SNI22/crucible_lite/docs/device_context.md

# Device Context — RAG Evidence Base

This file is the primary evidence document for all agents operating under the
Crucible Constitutional Governance system. It is read by attorneys before
constructing hearing arguments, by the hw-advisor before making suggestions,
and by the simulator-operator when validating simulation parameters against
known hardware behaviour.

**Agents: read this file before any hearing argument or advisory session.**  
**Humans: keep this file current. A stale BOM or outdated test result here is
a constitutional violation under Article I (Signal First).**

Maintained by: human engineer (primary) + `/toolchain` command (hardware/pin sections).  
Updated after: every field test session, every BOM revision, every schematic change.

---

## Device Purpose

This device detects falls of an elderly person in a bathroom by sensing floor
vibration, then prompts the user to confirm whether help is needed. If no
"no" response is received within a fixed timeout, the device escalates to an
external channel (caregiver / family / emergency services — escalation
transport is out of scope for this project). The dependency chain is:
floor-vibration event → on-device fall classification → user prompt →
verbal/manual acknowledgment or escalation. A false positive prompts the
elderly user unnecessarily (recoverable annoyance, budgeted at ≤ 1 per
7 days). A false negative leaves an injured or unconscious person on the
bathroom floor with no alarm — the catastrophic failure the device exists
to prevent.

**Project target:** Detect a fall of an elderly person on a bathroom-tile
floor at up to 3 m range, including the slow-controlled-descent (slump)
case, while rejecting heavy footsteps, dropped objects, and bathroom
plumbing vibration (shower / flush / drain).

**Pass/fail threshold:**
- Sensitivity ≥ 95 % of real falls detected within 30 s of fall onset,
  covering fast falls, slow slumps, and falls at the 3 m far-range case.
- False positive rate ≤ 1 alarm per 7 days of typical bathroom use.
- Detection latency: alarm prompt fires within 30 s of fall onset.

**Domain primitives** (traces to Article I — ratified by Amendment 1):
1. **Floor acceleration** (m/s²) — inertial response of the bathroom floor
   to mechanical events on it.
   Measured via: piezo (PVDF + proof-mass cantilever) at ≥ 1 kHz.
   FIRMWARE NOTE (2026-05-16): active firmware streaming rate is
   INT_MARK-dependent (0=~1.9 kHz default, 1=500 Hz, 2=200 Hz, etc.).
   The ≥ 1 kHz clause requires INT_MARK=0 in deployment.
2. **Acoustic pressure** (Pa, or normalized) — sound pressure in the
   bathroom air, both broadband (environment classification) and
   speech-band (verbal-response detection).
   Measured via: microphone (digital I2S MEMS recommended; pinned at
   `/toolchain init`).
3. **Human room occupancy** (boolean, with optional confidence) — whether
   a human body is present in the monitored room.
   Measured via: WiFi sensing module (output interface pinned at
   `/toolchain init`).

**Operating envelope:**
- **Normal:** ceramic / porcelain tile floor, PVDF+mass cantilever
  epoxied across full base footprint, ≤ 3 m max fall range, 15–30 °C,
  30–95 %RH, mains-powered, always-on 24/7.
- **Worst-case (still in-scope):** active shower running, toilet flush +
  tap running, neighbor footsteps through shared wall/floor, door slammed,
  brief second-person presence (helper / delivery), bath mat partially
  covering the floor, splash on enclosure (splash-rated, not submerged).
- **Out-of-scope:** outdoor / submerged deployment; multi-person
  bathrooms; floors over springy subfloor (joist over basement);
  carpet / soft flooring; rugs covering the device; detection of falls
  outside the monitored room; whole-house single-device monitoring.

---

## Install-Time Calibration Design (planned, Stage 2/3 deliverable)

To generalize across the wide variation in real bathrooms (tile size,
bonding, subfloor, wall coupling, ambient noise, sensor placement),
the device performs a one-time install calibration. This is the
generalization strategy of record per 2026-05-16 — the simulator does
NOT need to model every bathroom variation accurately; the install
calibration captures the actual deployment's response.

**Three-step install calibration:**

| Step | Duration | What is measured | How algorithm uses it |
|---|---|---|---|
| 1. Quiet baseline | 60 s | Ambient noise floor RMS + spectrum (vent, plumbing, washer if present) | Set adaptive event-detection thresholds; baseline-RMS becomes the denominator for SNR-based features |
| 2. Impulse test at 3 distances (calibrated jig-driven) | ~2 min | Impulse response at known xy positions (e.g., 0.5 m, 1.5 m, 2.5 m from sensor) | Measures actual plate damping, spatial decay rate, local tile resonance, and bonding state — ALL bathroom-specific physics in one measurement. Jig required (NOT fingernail) because result is fit quantitatively. |
| 3. Calibration walk | ~1 min | Real footstep signature at moderate pace | Confirms walking-discriminator features work in this bathroom; sets reference amplitude for "normal walking" used by adaptive thresholds |

**What this absorbs:**
- Multi-tile mosaic effects (lateral grout damping)
- Tile size + bonding state (local response in step 2)
- Subfloor variation (slab vs joist appears as different impulse response shape)
- Wall coupling (affects boundary modes captured in step 2)
- Vent / washer locations (captured in step 1 baseline)
- Sensor placement xy (implicit — the IR is from the sensor's actual location)

**What the algorithm requires to leverage calibration:**
- Adaptive event thresholds (MAD-based, already in `src/algorithm.py`)
- Scale-invariant features for classification (band fractions, ratios — partially in features; could be extended)
- Calibration-derivable amplitude reference (e.g., "fall energy ≥ K × measured-walking-energy" instead of "≥ X mg")
- Decay-time reference relative to plate signature ("post-event RMS returns to baseline in ≤ N × plate-ringdown-tau" instead of "≤ M ms")

The first two are in scope for the algorithm as it stands. The third
and fourth would be a feature-engineering pass at Stage 2/3, after
real calibration-measurement data is available.

**Simulator implications:**

This calibration strategy makes most per-bathroom simulator detail
unnecessary:
- Multi-tile mosaic modeling — defer (calibration captures lateral
  grout damping)
- Exact plate-damping value — defer (calibration measures the actual
  damping in impulse test)
- Exact bathroom geometry — defer (calibration captures spatial decay)
- Furniture mass loading — defer (captured in baseline)

The simulator IS still needed for:
- Algorithm development (representative-enough signals to validate logic)
- Structural physics that's bathroom-independent (multi-impact rebound,
  body-fall multi-stage signature, slow-slump dynamics, sensor model)

This re-prioritizes the simulator-improvement roadmap toward STRUCTURAL
features and away from per-bathroom parameter accuracy.

---

## Signal Inventory

| Signal | Physical quantity | Unit | Normal range | Hard limits | Sample rate | Primitive |
|---|---|---|---|---|---|---|
| Piezo (PVDF+mass) | Floor acceleration | m/s² (derived from V via charge-amp transfer function) | ±0.5 g typical bathroom activity | clip at front-end rail (≈ ±5 V at ADC input) | Active firmware: INT_MARK-dependent (default 0 → ~1.9 kHz; INT_MARK=1 → 500 Hz). Must be INT_MARK=0 to satisfy P1's ≥ 1 kHz clause | P1 |
| Microphone — broadband channel | Acoustic pressure | Pa (or 16-bit PCM count) | 30–80 dB SPL room ambient | clip at digital full-scale | 8–16 kHz (TBD at /toolchain init) | P2 |
| Microphone — speech-band channel | Acoustic pressure (300–3400 Hz) | Pa (or 16-bit PCM count) | response-time speech bursts | clip at digital full-scale | derived from broadband channel | P2 |
| WiFi sensing | Human room occupancy | boolean (+ optional confidence 0–1) | 0 or 1 with confidence ≥ 0.7 stable | sensor-not-responding watchdog | event-driven or 1 Hz poll (TBD) | P3 |

**Stretch / cost-gated sensors (deferred to /toolchain init decision):**
- PIR — only if WiFi-sensing presence proves unreliable in bathroom RF environment
- IMU on device housing — only if device housing itself gets bumped causing piezo false positives
- MLX thermal — likely too expensive; skip

**Pre-existing assets carried in from `~/Documents/piezo_circuit/`:**
- Charge-amplifier front-end (CA3140 or MAX44248, 100 MΩ ∥ 10 nF feedback)
- Sensor-mounting protocol (`SENSOR_MOUNTING.md` — PVDF+mass cantilever, full-area epoxy) — superseded by the housing design below for piezo_fall
- Walk-vs-fall characterization protocol (`WALK_VS_FALL_PROTOCOL.md`)
- Feature dictionary (peak, energy, duration, spectral centroid, band ratios, decay shape, multi-peak count, footstep cadence) — pending augmentation with a slump-rumble feature

**Deployment-specific sensor housing (piezo_fall):**

CAD file: `~/Documents/piezo_circuit/ground_cantilever_housing.{stp,stl}`
(user-designed, 2026-05-16, confirmed correct via review).

Architecture: 3 rigid sections stacked along Z, single rigid load path
from preload weight → top platform → PCB clamp → baseplate → floor.

| Section | Z range (mm) | Function |
|---|---|---|
| Baseplate | -8 to -5 | Square 35×35 mm, ~3 mm thick — flat ground contact. Single-tile sized (well under standard 200 mm bathroom tile, no grout-joint bridging). |
| PCB clamp / bracket | -5 to +10 | Through-slot grips MiniSense PCB edges. Pins/connectors route out top and bottom of the slot. Cantilever projects into the housing interior cavity with free air on all sides — no contact with walls or cap. |
| Top platform / cap | +10 to +14.5 | Cylindrical disc ~30 mm diameter, flat top — surface for the 200 g preload weight to sit on. |

**Preload:** ~200 g loose weight resting on top platform. Not bonded —
removable for transport, repeatable on re-install. Range 100–500 g all
acceptable; the figure isn't precision-critical.

**Why this preserves the datasheet sensor model:**

- Cantilever has free air around the tip mass → 2nd-order dynamics
  (fn ≈ 75 Hz, ζ ≈ 0.092) preserved. No clamping → no resonance shift.
- Rigid hard-on-hard load path (PLA/PETG print → MiniSense PCB →
  baseplate → tile) → base-on-floor follow-the-floor resonance well
  above 1 kHz. Faithful floor tracking in the 0–200 Hz band of interest.
- 35 mm baseplate within one tile → no inter-tile rocking modes.

**What still needs install-time impulse-test verification:**

Even with a correct housing design, the *as-deployed* coupling depends
on tile flatness, dust, the specific tile, and operator placement.
The 30-second impulse test in step 2 of the install calibration above
serves double duty: records IR data for fitting AND validates coupling
qualitatively (fingernail tap 30 cm from sensor → expect clean impulse
with ringdown < 50 ms). Long ringing or delayed rise = compliant contact,
fix the deploy before any further recording.
- ESP32-S3 host-streaming firmware (5 kHz reference; will be adapted to project firmware)
- Bedroom + livingroom test data; **bathroom fall data does not yet exist** and is a Stage 1 data-collection requirement

---

## Simulation Profile Catalog

> Locked at Stage 1 entry (2026-05-15). Each profile is a composite of one
> always-on background source (ventilator) plus optional plumbing/noise
> sources plus an optional event. Used by `src/signals.py::generate(profile, ...)`
> to produce labeled sensor traces for the detector under test.
> Background sources: `vent_humming` is always injected (always-on bathroom
> exhaust fan, ~50–60 Hz motor + harmonics). Other sources documented per profile.

### Class breakdown

| Class | Algorithm output | Purpose |
|---|---|---|
| **noise** | not-fall | Continuous/ambient sources, no discrete event. Tests baseline sensitivity. |
| **confuser** | not-fall | Discrete events that look fall-like but aren't. Tests discrimination logic. |
| **fall** | fall | The positive case. Tests sensitivity. |

### Profiles

| # | Profile | Class | Composition |
|---|---|---|---|
| 1 | `noise_vent` | noise | vent only |
| 2 | `noise_shower` | noise | vent + shower (continuous water-on-tile, ~3 min) |
| 3 | `noise_flush` | noise | vent + toilet-flush transient (~30 s) |
| 4 | `noise_washer_local` | noise | vent + washing machine on spin in same unit (direct floor coupling) |
| 5 | `noise_washer_neighbor` | noise | vent + neighbor's washer (through-wall + shared-floor attenuation) |
| 6 | `confuser_step` | confuser | vent + far step at 3 m (Case 2: far step ≈ close fall amplitude) |
| 7 | `confuser_drop_phone` | confuser | vent + light rigid drop (~150–200 g "phone-class" object). NOTE: name is legacy; real-world data collection MUST use a surrogate (power-adapter brick, hardback book, etc.) NOT an actual phone. See `docs/data_collection_protocol.md` Phase B2. |
| 8 | `confuser_drop_heavy` | confuser | vent + heavy rigid drop (~600 g hair dryer / electric razor) |
| 9 | `confuser_drop_glass` | confuser | vent + brittle multi-impact drop. NOTE: name is legacy; real-world data collection MUST use a SAFE multi-impact surrogate (small bag of dried pasta or marbles in a thin bag) — DO NOT break glassware in the bathroom. See `docs/data_collection_protocol.md` Phase B3. |
| 10 | `fall_fast` | fall | vent + fast fall at 3 m (200 J effective floor impact) |
| 11 | `fall_slump` | fall | vent + shower + slow slump at 3 m (worst case: slump + plumbing FP + far range) |

### Evaluation metrics

| Metric | Source | Target |
|---|---|---|
| Sensitivity | fraction of class `fall` correctly classified as fall | ≥ 95 % |
| FP rate on noise | fraction of class `noise` incorrectly classified as fall | ~ 0 % (easy) |
| FP rate on confuser | fraction of class `confuser` incorrectly classified as fall | drives ≤ 1/week target |
| Detection latency | fall-onset → classification | ≤ 30 s |

### Unmodeled scenarios (deferred — known gaps)

Recorded here so future agents do not re-investigate without authorization:
toilet-seat slam, elderly-style step (current `confuser_step` uses 70 kg
adult heel-strike), fall-with-grab-bar-support (partial controlled descent),
pet activity, adjacent-room footsteps, fall-onto-bath-mat (damped) vs
fall-onto-bare-tile. Add as Bill-level scope expansion if Stage 1 fails to
achieve target metrics on the locked catalog above.

---

## Bill of Materials (BOM)

| Ref | Component | Part Number | Value / Spec | Supplier | Notes |
|-----|---|---|---|---|---|
| U1  | MCU board | STM32F103C8T6 (blue pill) | 72 MHz ARM Cortex-M3, 64 KB flash | — | Firmware in `~/Documents/piezo_circuit/代码 - 调节发送频率/` |
| U2  | **Piezo sensor** | **MiniSense 100** | PVDF cantilever + integrated proof mass; fn ≈ 75 Hz, ζ ≈ 0.092; 1.1 V/g baseline / 6 V/g at resonance; source Z ≈ 650 MΩ @ 1 Hz | Measurement Specialties (TE Connectivity) | User-confirmed 2026-05-16. Simulator's sensor model in `src/signals.py` is calibrated to this datasheet. |
| U3  | Front-end op-amp | CA3140 / MAX44248 | FET-input, low bias current | — | High-Z buffer for PVDF source impedance |
| R48 | PVDF bias | — | 100 MΩ | — | Combined with PVDF Cs → ~6.5 Hz HP corner |
| J1  | Sensor connector | — | 2-pin | — | Sensor leads — shield grounded at front-end only |

**Known substitution constraints:**  
- **U2 (sensor):** if the MiniSense 100 is ever swapped for a different
  PVDF assembly (e.g. custom cantilever), the simulator sensor model in
  `src/signals.py` MUST be recalibrated to the new fn / ζ / sensitivity.
  This is a domain-primitive-affecting change → requires a Bill, not a
  silent edit. The source repo `~/Documents/piezo_circuit/` front-end is
  general-purpose (compatible with any PVDF sensor); the MiniSense 100
  identity comes from the deployment record, not the schematic.

---

## Circuit Notes

> Key connections, power rail topology, and any physical issues found during bring-up.
> Include anything an attorney might need to argue a signal-path or power-budget hearing.

### Power topology
- [e.g., "3.3V from on-board LDO via P1.08 software-switched power pin"]
- [e.g., "Battery: 3.7V Li-Po → USB-C charging via onboard PMIC"]

### Key signal paths
- [e.g., "IMU: I2C on SDA=P0.07 / SCL=P0.27, address 0x6A, INT1=P0.11"]
- [e.g., "LED RGB: P0.26 (red), P0.30 (green), P0.06 (blue) — active LOW"]

### Known circuit issues
- [e.g., "P0.27 is also the NFC antenna pin — configure as GPIO before use"]
- [e.g., "IMU power pin must be asserted HIGH ≥ 5ms before first I2C transaction"]

**Schematic revision:** [vX.Y — YYYY-MM-DD]  
**Schematic file:** [path or URL, or "not yet committed"]

---

## Test Results

> Structured record of every validation run. Agents cite entries here by date and type
> when making empirical arguments. An argument citing a test result not in this record
> is inadmissible under the Benjamin Franklin Principle.

### Field / HIL test log

| Date | Stage | Test type | Profile / scenario | Key measurement | Pass/Fail | Notes |
|---|---|---|---|---|---|---|
| YYYY-MM-DD | 0 | HIL smoke | USB serial | [e.g., counter=100 ✓] | PASS | — |
| YYYY-MM-DD | 0 | HIL smoke | IMU I2C | [e.g., WHO_AM_I=0x6A ✓] | PASS | — |
| YYYY-MM-DD | 1 | Simulation | [profile] | [e.g., steps=100, SI=2.1%] | PASS | — |
| YYYY-MM-DD | 2 | Firmware | [scenario] | [e.g., SESSION_END in 18s] | PASS | — |

### Signal measurements (evidence pool)

> Discrete measurements cited in case law or Bills. Each entry must name the file
> and the physical quantity it supports.

| Date | Signal | Value | File / log | Physical quantity |
|---|---|---|---|---|
| YYYY-MM-DD | [e.g., gyr_y peak] | [e.g., 38.4 dps] | [log path] | [e.g., push-off angular velocity] |
| YYYY-MM-DD | [e.g., SI_interval] | [e.g., 2.3%] | [log path] | [e.g., bilateral symmetry] |

### Open anomalies

> Issues observed but not yet explained or resolved. An attorney may cite an open
> anomaly as evidence that a position is unsafe — it has the same weight as a
> confirmed measurement.

| Date observed | Description | Stage | Status |
|---|---|---|---|
| YYYY-MM-DD | [what was seen] | [N] | [open / investigating / resolved YYYY-MM-DD] |

---

## Hardware Bring-up History

> Chronological record of significant hardware events: new revisions, failures,
> component swaps, and the reason for each. Attorneys use this to establish whether
> a current anomaly has a hardware precedent.

| Date | Event | Impact | Action taken |
|---|---|---|---|
| YYYY-MM-DD | [e.g., Rev A board received] | — | [toolchain init run] |
| YYYY-MM-DD | [e.g., I2C pullup too weak — 10kΩ → 4.7kΩ] | [IMU lost comms at 400kHz] | [BOM updated] |

---

## Agent Reading Guide

| Agent | Sections to read | Why |
|---|---|-----|
| Attorney-A / B | All | Full evidence base before constructing any argument |
| hw-advisor | Device Purpose, BOM, Circuit Notes, Open Anomalies | Grounds suggestions in actual hardware |
| simulator-operator | Signal Measurements, Test Results | Validates simulation output against known hardware |
| uart-reader | Test Results, Signal Measurements | Contextualises printed UART output |
| plotter | Domain Primitives, Signal Measurements | Ensures plot annotations use correct physical units and thresholds |
| stage-compactor | Test Results, Hardware Bring-up History | Verifies stage exit criteria before freezing precedents |
