SNI22/crucible_lite/docs/toolchain_config.md

# Toolchain Configuration

> **Written and maintained by `/toolchain` commands only.**  
> All agents read this file before taking any toolchain-dependent action.  
> Human edits are permitted but must be followed by `/toolchain validate`.

---

## Lock Status

```
Status:  UNLOCKED
Locked:  —
Evidence: —
```

---

## Hardware

```
Board:    Custom STM32F103 PVDF Signal Conditioning PCB (revision 2023-02-20)
          Schematic: ~/Documents/piezo_circuit/PVDF压电采集资料/PVDF压电采集系统资料/
                     Schematic_PVDF压电信号调理系统_2023-02-20.pdf
MCU:      STM32F103C8T6, ARM Cortex-M3, 72 MHz, 64 KB flash / 20 KB SRAM, LQFP-48
Sensors:  PVDF + proof-mass cantilever (off-board, via H1 1×2 header).
          Mounting per ~/Documents/piezo_circuit/SENSOR_MOUNTING.md —
          full-area epoxy to ceramic tile floor; ≤ 3 m max range.
External: Linux PC with conda (development host for this loop — running receiver.py
          and detection algorithm; this is the machine the Crucible session runs on).
          Raspberry Pi 5 deferred to a future stage (Stage 4 — Host Integration) for
          eventual deployment; not in scope for Stage 0–3 this loop.
          ST-Link V2 or J-Link SWD probe;
          USB-UART adapter (CH340 on Alientek "Warship" board if used, or external).
Notes:    Scope-reduced pass — only P1 (floor acceleration) implemented.
          P2 (microphone) and P3 (WiFi sensing) deferred to a future stage gate.
          ACTIVE FIRMWARE IDENTIFIED 2026-05-16: located at
          ~/Documents/piezo_circuit/代码 - 调节发送频率/USER/main.c
          (FW-IDENTITY-UNRESOLVED finding from Stage 0 ruling is now RESOLVED).
          Active firmware uses USART2 (NOT USART1) at PA2/PA3, routed through
          PCB H6 header. Voltage conversion: (ADC × 3.3 / 4069) - 1.65V.
          Known issues in active firmware (different from older firmware):
            (1) Divisor typo: 4069 should be 4095 — ~0.6% systematic voltage error
            (2) Streaming rate is INT_MARK-dependent (variable 50-1920 Hz)
            (3) 1.65V mid-rail bias is hard-coded (no per-board calibration)
          The OLD firmware's `accur=0.015295` and `1890 ADC offset` violations
          do NOT exist in this version — the signal chain is different.
          HCNR200-500E linear optocoupler in BOM but not in current build.

          Alternative signal path (contingency, not current build):
          Tap the analog output of the OP07 final gain stage (test header H3/H4)
          directly into an external high-precision ADC reachable from the host
          (e.g., USB ADC dongle for the Linux PC this loop; Pi-mounted ADC hat
          later if/when deployment moves to Pi 5).
          The STM32 MCU then becomes inactive — the host PC does sampling and analysis.
          Useful escape valve if the STM32 onboard ADC's ~47.6 kS/s + 12-bit
          resolution proves inadequate (noise floor, dynamic range, or aliasing on
          tile floors). Prior repo's ~/Documents/piezo_circuit/raspberry_pi/ folder
          attempted ADS1263 at 7200 SPS → decimated to 5000 SPS but was abandoned
          due to DOA hat hardware; a replacement hat would resurrect this path.
          Switching to this path is a Bill-level change (Amendment 3) — not allowed
          mid-stage.
```

---

## Pin Map

| Signal | STM32 pin | Port/pin | Function | Caution |
|---|---|---|---|---|
| Piezo_ADC | PA6 | ADC1_IN6 | Analog input from OP07 U9 output (post-conditioning) | Sampled at 47.6 kS/s, 239.5-cycle sample time, DMA1 Ch1 |
| Dout_Trigger | PB15 | EXTI15 | LM311 comparator output (event trigger) | Threshold set by RP5 trim — record current setting in calibration log |
| UART2_TX | PA2 | USART2 TX | UART to host @ 115200 baud (ACTIVE firmware) | Routed through PCB H6 header |
| UART2_RX | PA3 | USART2 RX | UART from host @ 115200 baud | Currently unused in active main loop |
| UART1_TX | PA9 | USART1 TX | NOT USED in active firmware (legacy: old firmware used this) | Wired to H15 header — inactive |
| UART1_RX | PA10 | USART1 RX | NOT USED in active firmware | Inactive in current build |
| OLED_SCL | PB6 | I2C1 SCL | OLED SSD1306 clock | 5.1 kΩ pull-up to 3.3 V (R58) |
| OLED_SDA | PB7 | I2C1 SDA | OLED SSD1306 data | 5.1 kΩ pull-up to 3.3 V (R59) |
| XTAL_IN | OSC_IN | — | 8 MHz HSE crystal X2 | 22 pF load caps C11/C12 |
| XTAL_OUT | OSC_OUT | — | 8 MHz HSE crystal X2 | — |
| RESET | NRST | — | Reset button | Pull-up R12 10 kΩ |
| BOOT0 | BOOT0 | — | Bootloader select on H15 header | Tied LOW for normal boot |
| Debug_GPIO | PA11, PA2, PA3, PA4 | GPIO | Header H6 (general I/O) | Currently unused |

---

## Active Firmware Toolchain

```
Build:          Keil MDK-ARM (free size-limited edition; image < 32 KB)
                Project: ~/Documents/piezo_circuit/代码 - 调节发送频率/USER/Template.uvprojx
                  (ACTIVE — confirmed 2026-05-16; resolves FW-IDENTITY-UNRESOLVED)
                Library: ST Standard Peripheral Library (SPL, vendored — not HAL/CubeMX)
                Build host: Windows laptop (Keil is Windows-only; no Linux/CLI build path)
                Status: firmware located + analyzed; frozen for this stage gate
                Signal chain: ADC1 ch6 (PA6), 28.5-cycle sample @ ~290 kS/s,
                  DMA-driven into ADC_DMA_IN. Main loop reads + transmits
                  `"%.3f\n"` (FireWater format) on USART2 @ 115200 baud.
                  Voltage = (ADC × 3.3 / 4069) - 1.65V.
                  Streaming rate = main-loop iteration rate, INT_MARK-dependent:
                    INT_MARK=0 (default): ~1.9 kHz (UART-throughput-limited)
                    INT_MARK=1: 500 Hz   (2 ms delay)
                    INT_MARK=2: 200 Hz   (5 ms delay)
                    INT_MARK=3: 100 Hz   (10 ms delay)
                    INT_MARK=4: 50 Hz    (20 ms delay)
                Known issues: 4069 divisor typo (should be 4095), hard-coded
                  1.65V mid-rail (no per-board calibration). Both NEW Article I
                  candidates; less severe than old firmware's accur+offset.
                IWDG (independent watchdog) enabled — firmware self-resets on hang.
Flash:          ST-Link V2 SWD (primary) via Keil µVision built-in flasher
                Alternative: UART bootloader via BOOT0 = HIGH on H15 header +
                             `stm32flash` on the Linux PC host
Serial monitor: ~/Documents/piezo_circuit/receiver/receiver.py
                  PC-side capture (CSV write + key-tag events) on the Linux PC
                  development host (conda env — package versions pinned at
                  /toolchain scaffold)
                  Formats: FireWater (ASCII "%.3f\n") — matches active firmware
                  Baud: 115200 (firmware USART2 setting)
                  CSV schema: sample_index,value,event
                  Transport: USB-UART via USART2 on PA2/PA3 (active firmware path).
                             Bluetooth-serial bridge (HC-05/06) would attach to USART2
                             output, but USB-UART is the default deployment path.
                Alternative for quick checks: minicom -b 115200 -o -D /dev/ttyUSB0
Wireless recv:  N/A — STM32F103 has no onboard wireless
                Alerts: routed via the development host (network/SMS/etc.,
                  implementation TBD; Pi 5 takes this role at Stage 4)
                WiFi sensing module (P3): deferred to a future stage gate
Simulation:     ~/Documents/piezo_circuit/analysis/floor_sim.py
                  OpenSeesPy Kirchhoff plate model with `bathroom` preset
                  Emits CSV in same sample_index,value,event format as receiver.py
                  Enables signal-only Stage 1 simulation path (no firmware-in-loop required)
                Signal-only path is the primary Stage 1 simulator.
                Renode-based firmware-in-loop simulation: not configured (STM32F103
                  is Renode-supported but not wired up here; defer unless needed).
```

---

## Blocked Toolchains

None.

**Project cost constraint** (not a block, a guideline for advisors and Bill drafters):
This pass operates on the existing PVDF + STM32F103 PCB hardware. Any proposed
hardware addition that requires a new component purchase, a new PCB spin, or a
new MCU (e.g., MLX thermal camera, dedicated audio codec board, dual-MCU architecture)
is "too costly" for this stage and must be raised as a Bill with explicit cost
justification before procurement. The hw-advisor and bill-drafter must flag any
suggestion that would breach this constraint.

This is not a formal `/toolchain block` — it is a budget gate. A future Bill may
relax it for a specific component without requiring a Judicial Hearing.

---

## Firmware UART Format

> **Required for `/toolchain scaffold`** — fill in before running Stage 1.  
> This section defines what the firmware emits over UART. It is used to  
> generate `src/analysis.py` (UART parser) and `src/events.py` (event types).

```
session_end_marker: SESSION_END
```

### Event Definitions

> One block per UART event type the firmware emits. Add blocks as needed.

```
[[event]]
name:     > [logical name — e.g., "primary_event", "snapshot", "reading"]
marker:   > [text prefix that identifies this line — e.g., "STEP", "READING", "SNAPSHOT"]
pattern:  > [full regex — e.g., r"STEP\s+#(\d+)\s+ts=(\d+)\s+value=([\d.]+)"]
fields:   > [comma-separated field names matching capture groups — e.g., "index, ts_ms, value"]
types:    > [comma-separated Python types — e.g., "int, float, float"]
```

### Binary Export Format (optional)

> Fill in only if firmware supports a binary bulk export over BLE or UART.

```
magic:  > [4-byte magic — e.g., "PROJ" or leave blank]
struct: > [Python struct format string — e.g., "<IIHHBb"]
fields: > [comma-separated field names matching struct groups]
scale:  > [comma-separated scale factors — e.g., "1, 1, 0.1, 0.1, 1, 1"]
```

---

## Library Manifest

> Use `/toolchain add lib` to add entries. Host-side Python versions pinned at
> `/toolchain scaffold` (when `src/` modules are generated).

### Firmware-side (Keil MDK, vendored — no package manager)

| Library | Version | Source | Purpose | Known issues |
|---|---|---|---|---|
| STM32F10x_StdPeriph_Lib | V3.5.0 (ST Standard Peripheral Library) | Vendored at `~/Documents/piezo_circuit/代码 - 调节发送频率/STM32F10x_FWLib/` | Low-level peripheral access (ADC, DMA, USART, GPIO, RCC) — predates HAL/Cube | Deprecated by ST since 2014; long-term Bill candidate to migrate to HAL/LL |
| CMSIS Core (Cortex-M3) | per Alientek Warship template (to verify) | Vendored at `~/Documents/piezo_circuit/代码 - 调节发送频率/CORE/` | ARM Cortex-M3 core abstraction, startup, `system_stm32f10x.c` | — |
| OLED SSD1306 driver | local (author-written) | `~/Documents/piezo_circuit/代码 - 调节发送频率/HARDWARE/OLED/` | I2C OLED waveform / voltage display | Two drivers coexist (`OLED_I2C` + `OLED0561`); `main.c` calls both Init paths |

### Host-side (Linux PC, conda env `piezo_reader` — verified at /session 0 init)

| Library | Version | Source | Purpose | Known issues |
|---|---|---|---|---|
| Python | 3.14.3 | conda | Runtime | — |
| numpy | 2.4.3 | PyPI | Numerical arrays for analysis and simulation | — |
| scipy | 1.17.1 | PyPI | Signal processing (filters, FFT, envelope) | — |
| matplotlib | 3.10.8 | PyPI | Plotting (plotter agent uses `Agg` backend) | — |
| pyserial | 3.5 | PyPI | `receiver.py` serial bridge | — |
| PyQt5 | 5.15.11 | PyPI | `receiver.py` interactive GUI | — |
| pyqtgraph | 0.14.0 | PyPI | `receiver.py` live plot | — |
| openseespy | **NOT INSTALLED** | PyPI | Kirchhoff plate floor simulator (`floor_sim.py`) | Required for Stage 1; install before opening Stage 1 |

---

## Repository Registry

> One entry per git repository in use. Use `/toolchain add repo` to add entries.

| Repo | Path | Remote | Branch | Purpose | Access |
|---|---|---|---|---|---|
| piezo_fall | /home/sni22/crucible/piezo_fall | (TBD — no remote configured yet) | master | This project — Crucible-governed fall detection | read+write |
| piezo_circuit | /home/sni22/Documents/piezo_circuit | git@github.com:SNI22/piezo-circuit.git | main | Prior fall-detection work — reference for STM32 firmware (Keil), custom PCB schematics, `receiver.py`, `analysis/floor_sim.py`, sensor-mounting protocol, feature dictionary, prior test data | **read-only** — agents in this project may not commit to this repo |
| crucible-core | /home/sni22/crucible/core | (no remote) | master | Crucible governance framework template — source of CONSTITUTION.md / amendments.md / agent definitions for this project | **read-only** |

---

## Stage Status

```
Spec Gate  — Device Specification:  CLOSED 2026-05-15 (Amendment 1 ratified, commit e06398e)
Stage 0    — HIL Toolchain Lock:    PENDING-WITH-OPEN-FINDINGS 2026-05-15
                                    (Justice declaration; see Stage 0 Ruling below)
Stage 1    — Simulation:            OPEN — Path A only (signal-only Python)
Stage 2    — Firmware Integration:  BLOCKED on FW-IDENTITY-UNRESOLVED
Stage 3    — Field Test:            NOT STARTED
Stage 4    — Host Integration:      NOT STARTED
```

### Stage 0 Ruling — Justice declaration, 2026-05-15

Stage 0 is marked PENDING (not formally CLOSED) and Stage 1 Path A is
authorized to proceed under Article II Justice authority. Three open
findings are recorded for future audit:

- **FW-IDENTITY-UNRESOLVED.** The STM32 `main.c` in
  `~/Documents/piezo_circuit/PVDF压电采集资料/采集代码/USER/main.c`
  (the toolchain-registered firmware) never calls `uart_init(115200)`
  and contains no `printf` / `USART_SendData` calls. It cannot produce
  the UART stream that `receiver.py` captured into the prior repo's
  CSVs. The active streaming firmware lives elsewhere — most likely a
  modified `main.c` on the user's Windows laptop (Keil host). Locating
  and reading that firmware is deferred to Stage 2 entry; Path A
  simulation in Stage 1 does not require it.

- **SAMPLE-RATE-UNMEASURED.** Amendment 1 specifies "≥ 1 kHz piezo"
  but no empirical measurement of the firmware's actual UART
  streaming rate has been recorded. Resolution deferred to Stage 2.

- **BT-BRIDGE-HYPOTHESIS-REJECTED.** Investigated and rejected: an
  HC-05/06 Bluetooth-serial bridge is passive transport — it cannot
  generate UART data on its own; the MCU firmware must still call
  `USART_SendData` (or equivalent). Recorded here so future agents do
  not re-investigate this dead end.

**Authorized work this loop:** Stage 1 Path A (signal-only Python
simulation: `floor_sim.py` → `src/signals.py` → `src/algorithm.py` →
metrics, validated against pass/fail threshold).

**Blocked work this loop:** Path B (Renode firmware-in-loop), Stage 2
(firmware integration), `/toolchain scaffold` (requires
`## Firmware UART Format` which requires firmware identity).

A future stage gate may upgrade Stage 0 to CLOSED once the three
findings are resolved.

---

## Stage 0 — Adapted HIL Toolchain Lock Protocol

The framework default Stage 0 assumes four sequential flashable test programs
(counter → sensor readout → algorithm-on-MCU over USB → algorithm-on-MCU over
wireless). This project's architecture does not fit that model: the MCU
performs sampling + UART streaming only, and the algorithm runs on the
Linux PC host (this loop; Pi 5 takes this role at Stage 4 later).
The protocol below is the adapted Stage 0 for piezo_fall; it preserves
the intent of the framework's gates (prove the entire pipeline works before
algorithm development) while matching the actual hardware.

| Gate | Test | Pass criterion |
|---|---|---|
| **0.1** | **MCU alive.** Power the STM32 (custom PCB or Alientek Warship dev board), connect transport (USB-UART or HC-05/06 BT-serial bridge) to the Linux PC receiver, run `receiver.py`. | Continuous UART data stream visible in receiver.py at 115200 baud; no resets across a 60-second observation window. |
| **0.2a** | **ADC plausibility.** With piezo sensor connected, observe the live receiver.py trace at rest, then tap the floor 30 cm from the sensor. The receiver displays values in volts (post firmware (ADC × 3.3 / 4069) - 1.65V conversion). | Quiet baseline near 0 V (mid-rail subtracted by firmware), small drift ±50 mV acceptable; clear transient spike clearly above baseline on tap. |
| **0.2b** | **Streaming rate verification.** Record current INT_MARK setting on the device; capture a 10-second receiver.py session at rest; count sample rows in the resulting CSV. | At INT_MARK=0: ≥ 15,000 rows (~1.9 kHz × 10 s). At INT_MARK=1: ~5,000 rows (500 Hz). At lower INT_MARK values, fewer rows. To satisfy Amendment 1's "≥ 1 kHz piezo" clause: INT_MARK MUST be 0. Record the actual INT_MARK + measured rate in `device_context.md` Test Results table per session. |
| **0.3** | **Receiver capture end-to-end.** Capture a 30-second receiver.py session; key-tag one "step" event with SPACE while tapping near the sensor. | Valid CSV with `sample_index,value,event` schema; the tagged event row exists at a sample index close to the actual tap (within receiver.py's documented tag latency). |
| **0.4** | **Wireless / transport check.** If the deployment uses an HC-05/06 BT-serial bridge, repeat gate 0.1 over BT instead of USB and confirm receiver.py captures equivalently. If deployment is USB-only, explicitly record that and skip this gate. | BT capture matches USB capture in format and continuity for ≥ 60 s, OR explicit "BT not in deployment scope — USB-only" record in Test Results table. |

**Procedure for each gate:** human executes the hardware action; the result
is recorded in `docs/device_context.md` Test Results table by the human; the
session orchestrator confirms recorded pass/fail and gates the next test.

**[JUSTICE GATE S0]** All four gates pass + records committed → invoke
`stage-compactor` to close Stage 0 → run `/toolchain lock` to stamp the
config as Stage 0 validated.

---

## Constitutional References

- **Amendment 3 (Toolchain Alignment):** This file is the live implementation of the active toolchain record. Any change to the active toolchain requires updating this file and ratifying or amending Amendment 3.
- **Amendment 4 (Three-Strike Rule):** Blocked toolchain entries in this file are the formal record of strikes. Three strikes → block mandatory.
- **Amendment 2 (Stage Gate Order):** Stage status table above is the authoritative gate record. Stage N cannot open until Stage N-1 is CLOSED here.
