SNI22/crucible_lite/cad/jig_preview.png

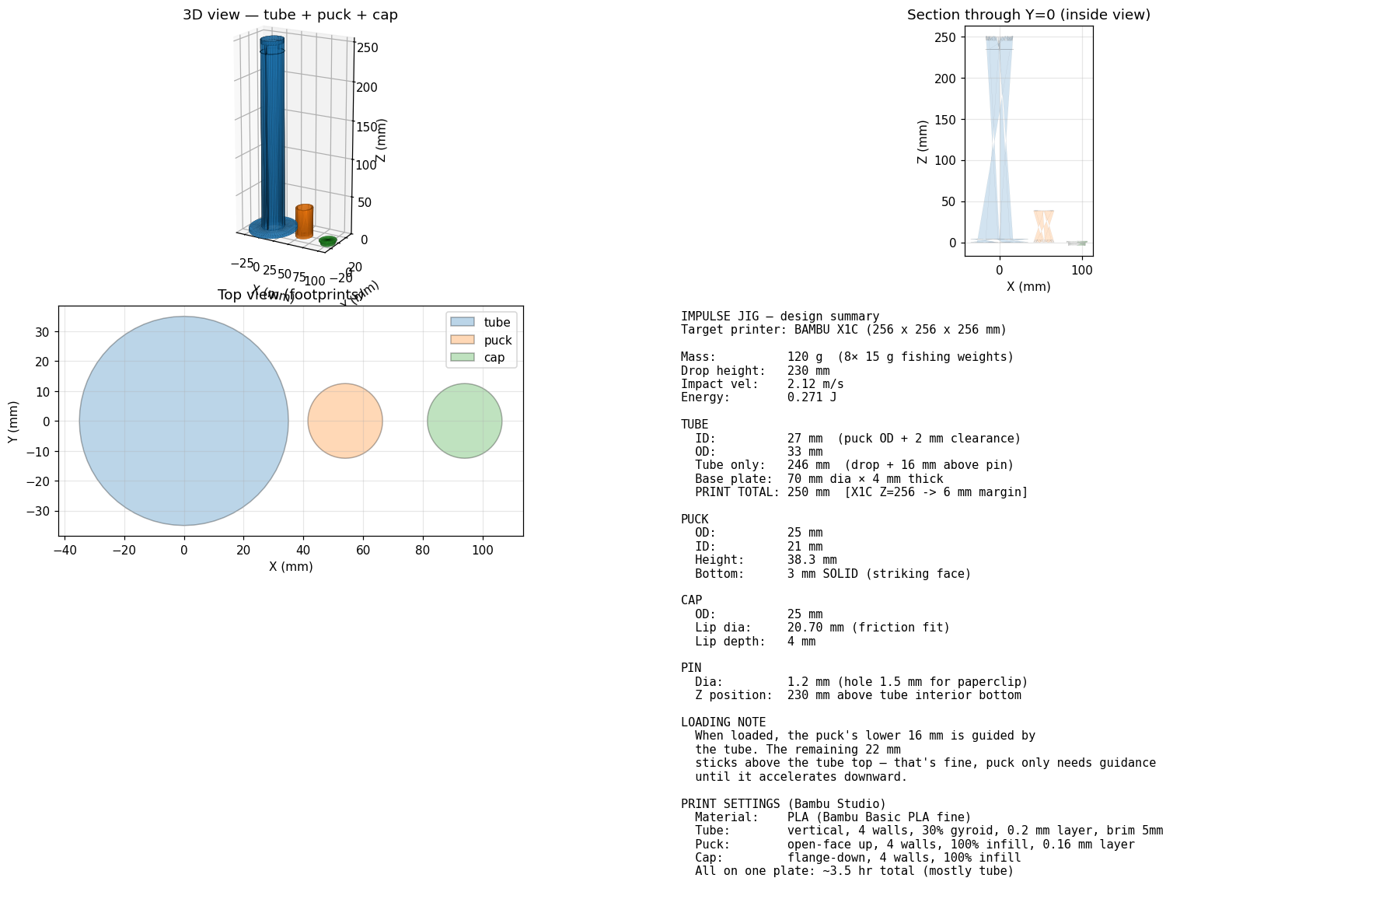
cad/jig_preview.png
