SNI22/crucible_lite/docs/plots/real_noise_spectrum.png

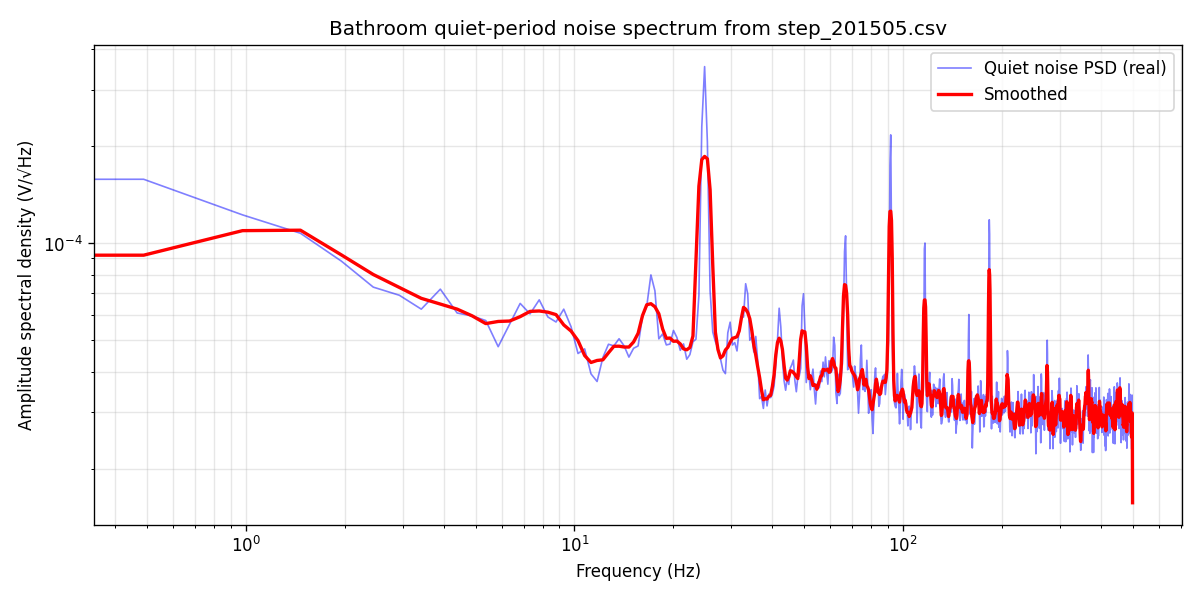
docs/plots/real_noise_spectrum.png
