SNI22/crucible_lite/docs/plots/real_vs_synth_footstep.png

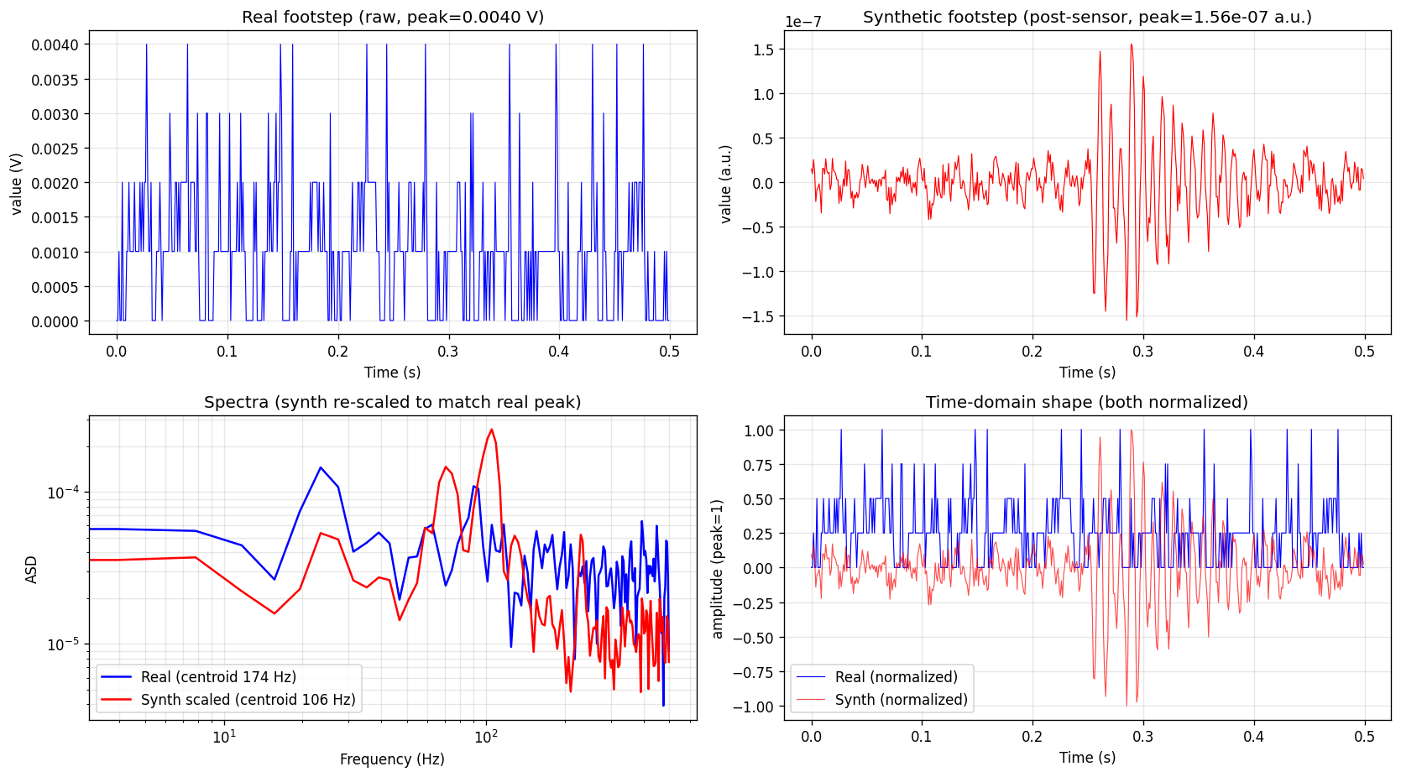
docs/plots/real_vs_synth_footstep.png
