SNI22/crucible_lite/docs/plots/real_vs_synth_footstep_by_distance.png

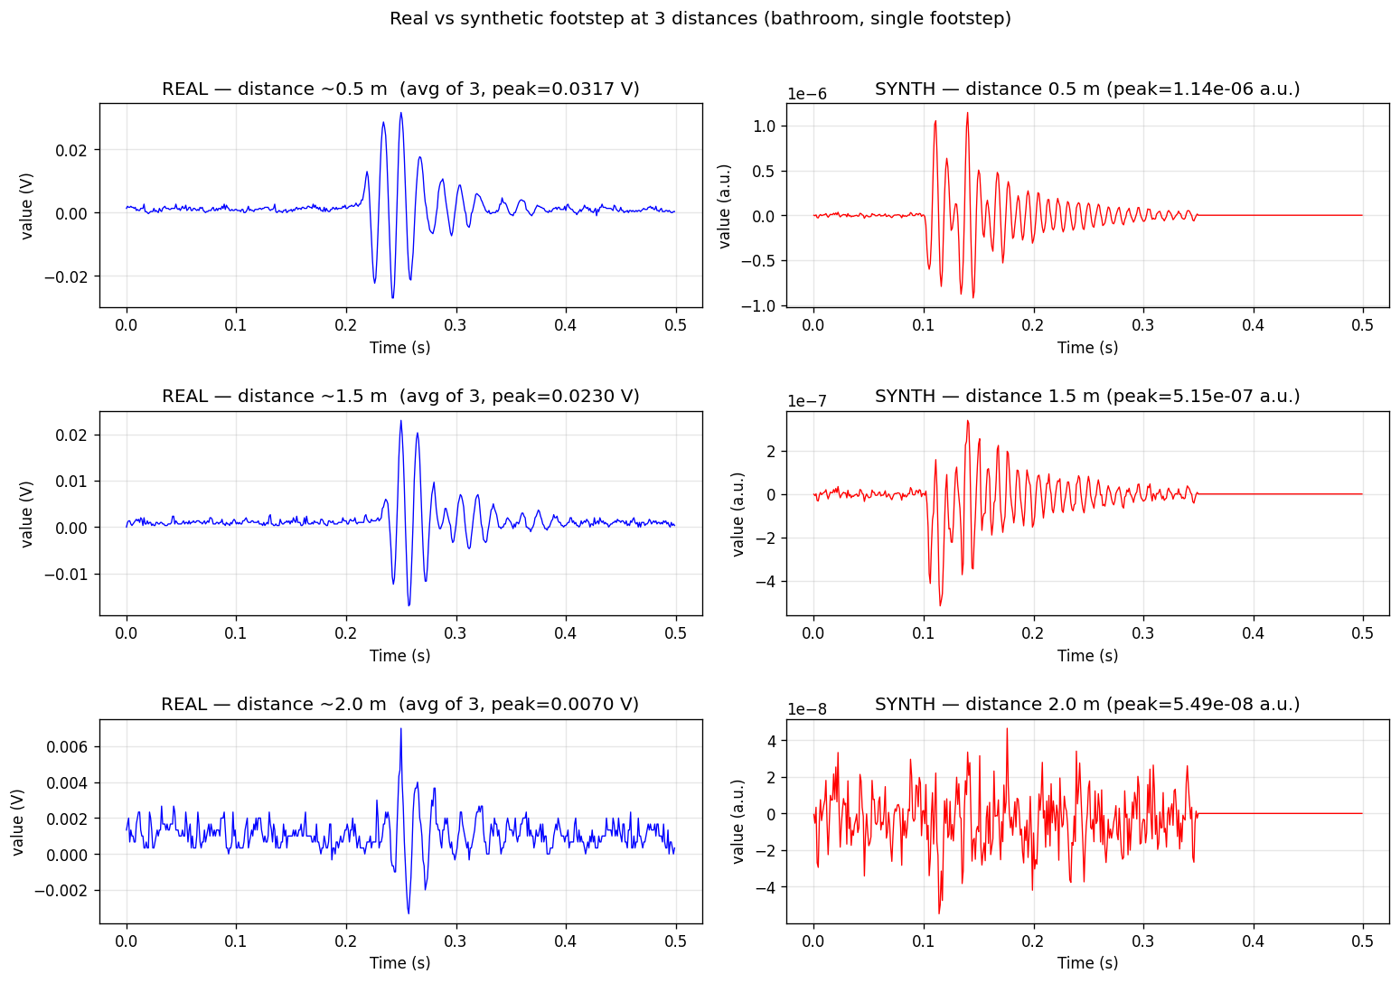
docs/plots/real_vs_synth_footstep_by_distance.png
