SNI22/crucible_lite/docs/plots/sensor_model_bode.png

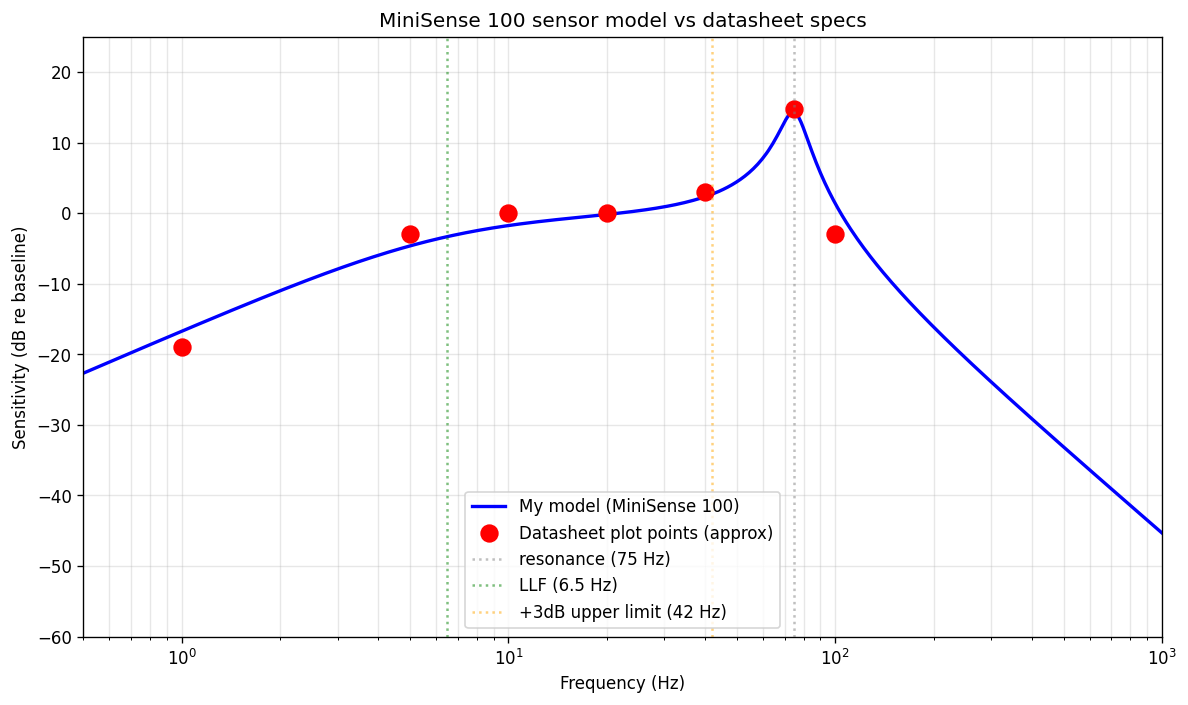
docs/plots/sensor_model_bode.png
