SNI22/crucible_lite/docs/plots/sim_layout_diagram.png

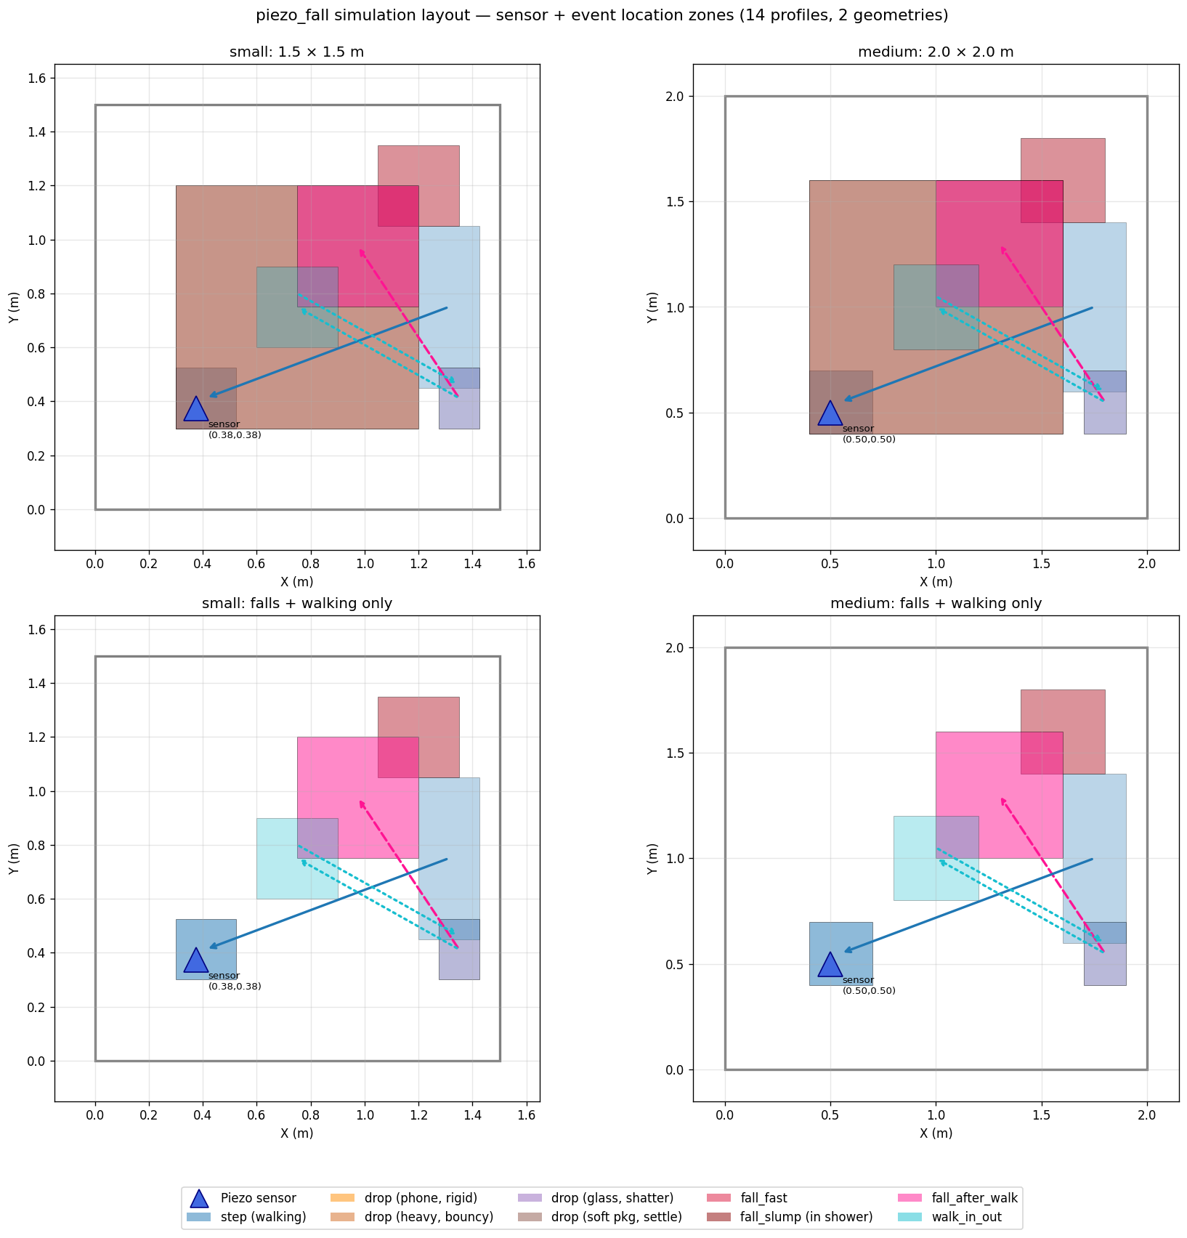
docs/plots/sim_layout_diagram.png
