SNI22/crucible_lite/docs/plots/sim_render/fall_after_walk__small__seed42.png

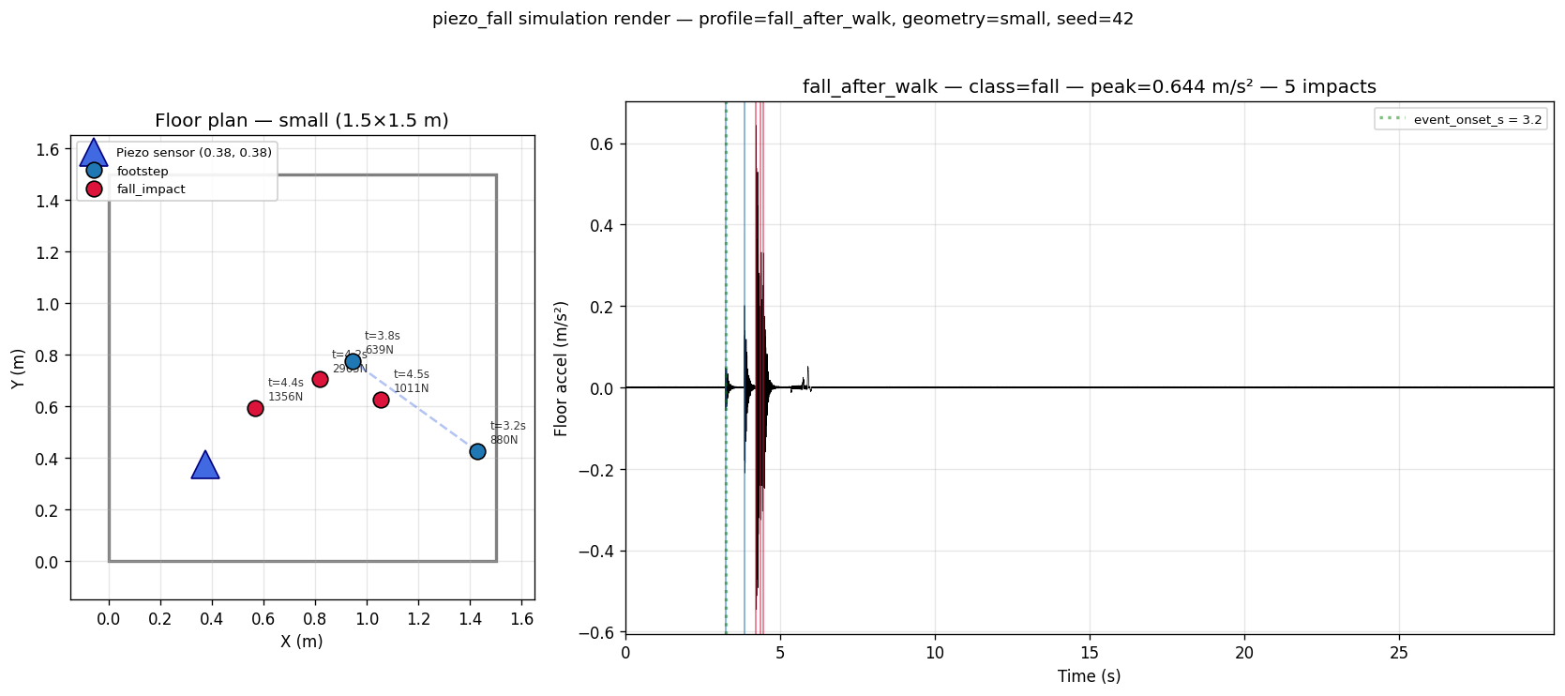
docs/plots/sim_render/fall_after_walk__small__seed42.png
