SNI22/crucible_lite/docs/plots/sim_render/fall_slump__medium__seed42.png

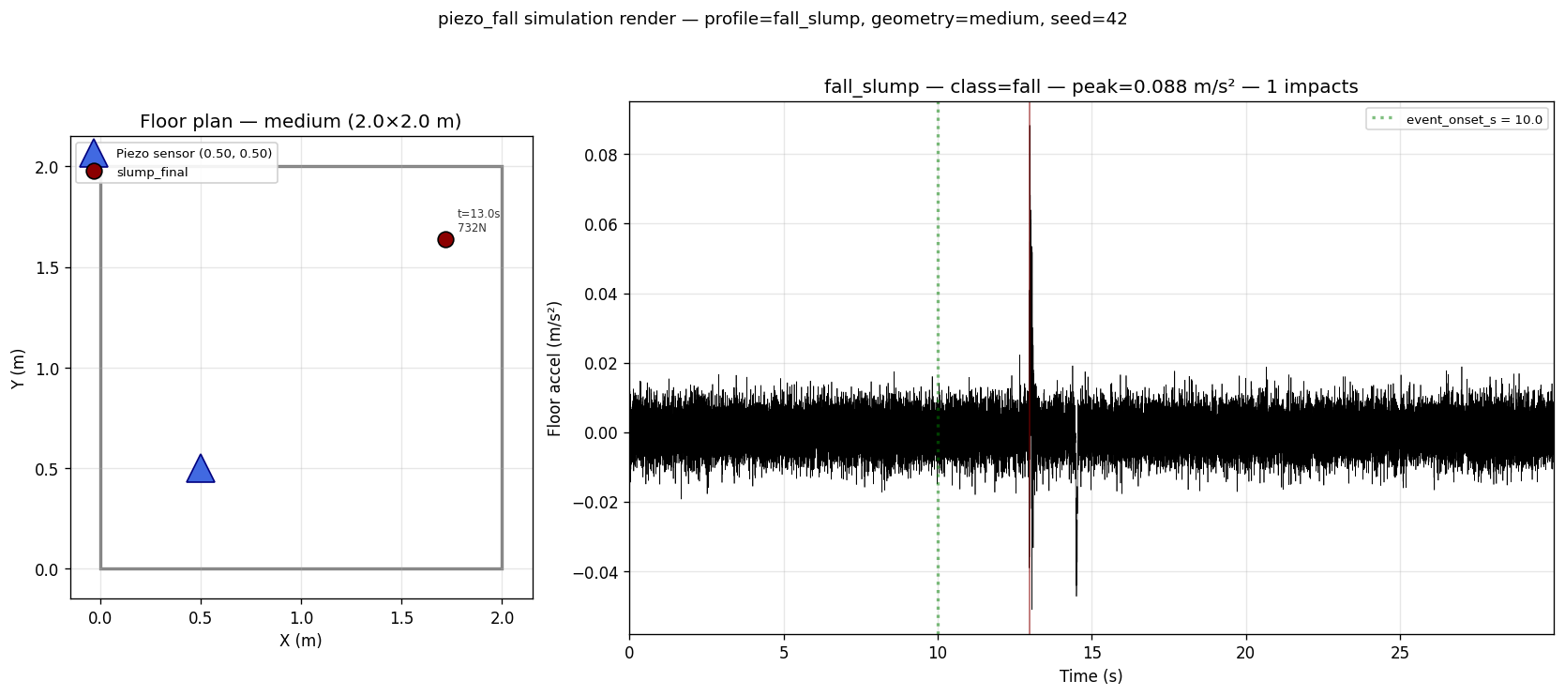
docs/plots/sim_render/fall_slump__medium__seed42.png
