SNI22/crucible_lite/docs/plots/sim_render/noise_shower__medium__seed42.png

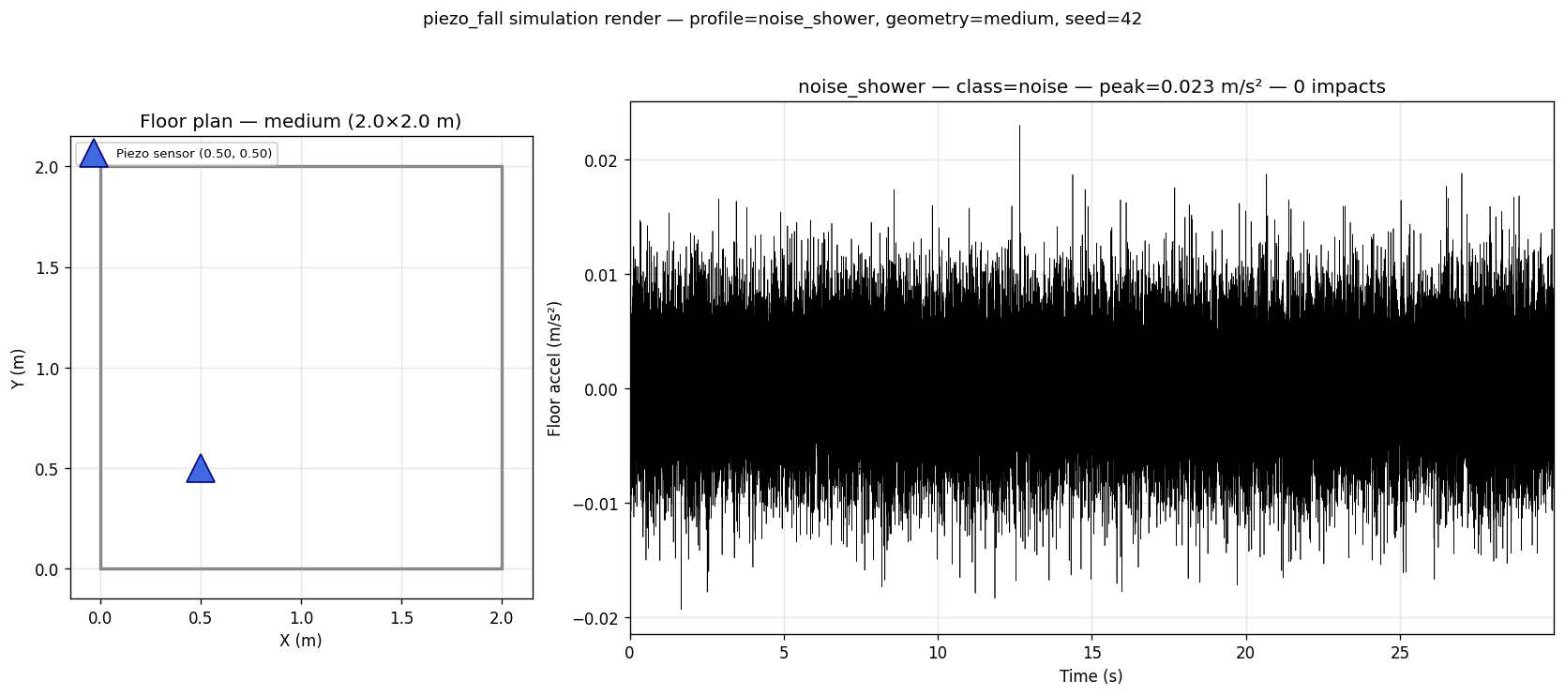
docs/plots/sim_render/noise_shower__medium__seed42.png
