SNI22/crucible_lite/docs/plots/sim_render/noise_washer_local__medium__seed42.png

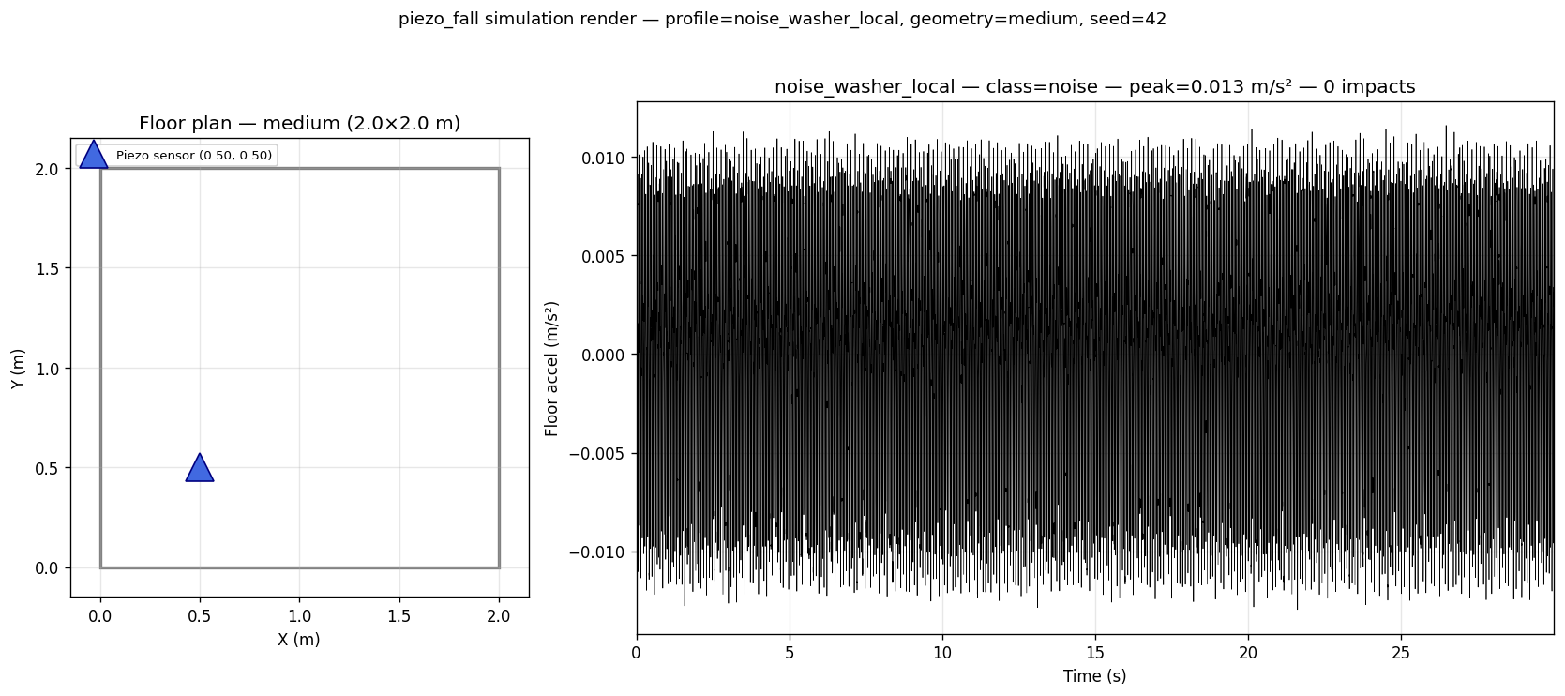
docs/plots/sim_render/noise_washer_local__medium__seed42.png
