SNI22/crucible_lite/docs/plots/sim_render/walk_in_out__medium__seed42.png

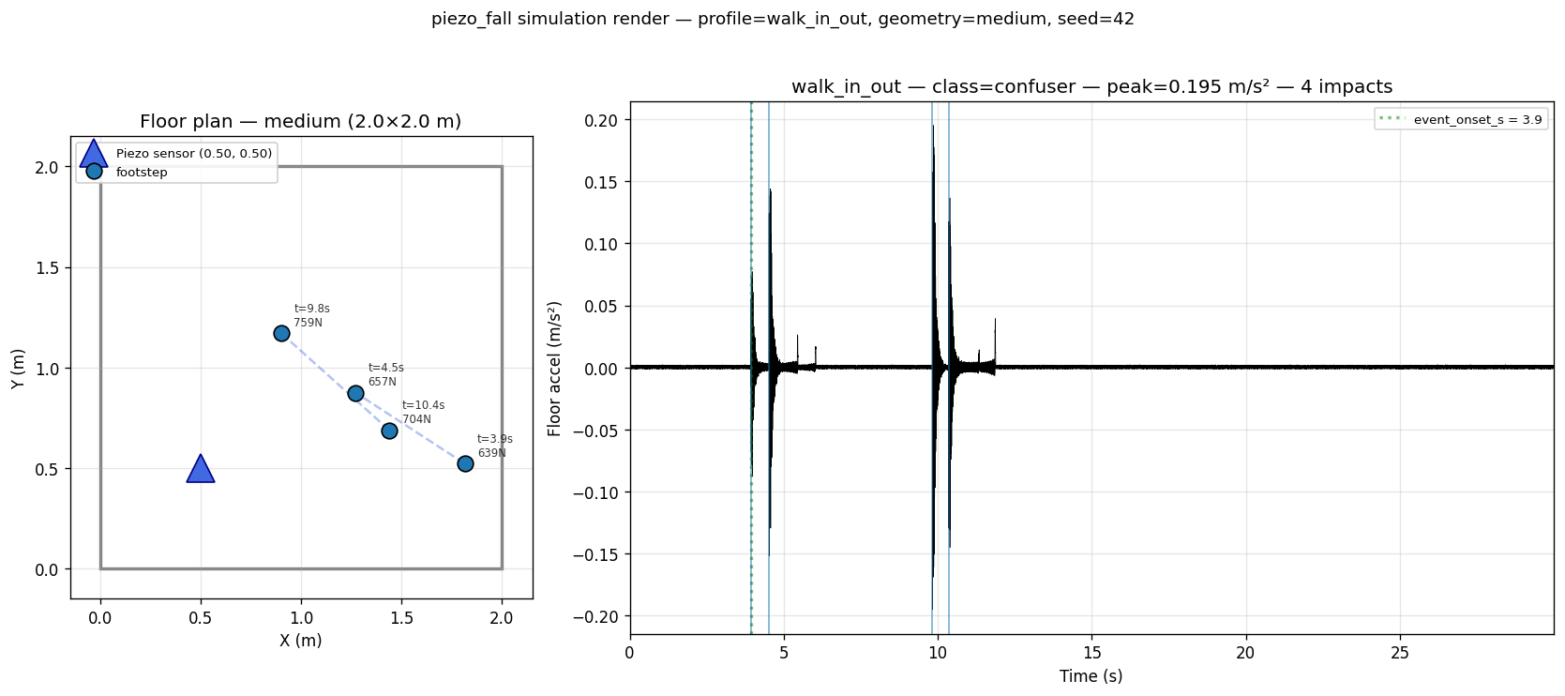
docs/plots/sim_render/walk_in_out__medium__seed42.png
