SNI22/crucible_lite/cad/jig_tube.stl

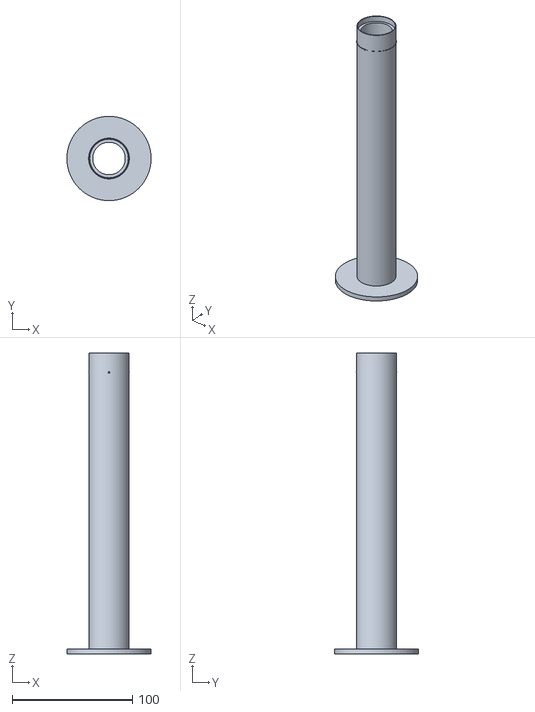
[picture p19: CAD file, 2026-05-17]
cad/jig_tube.stl
70.0 x 70.0 x 250.0
