SNI22/crucible_lite/cad/jig_puck.stl

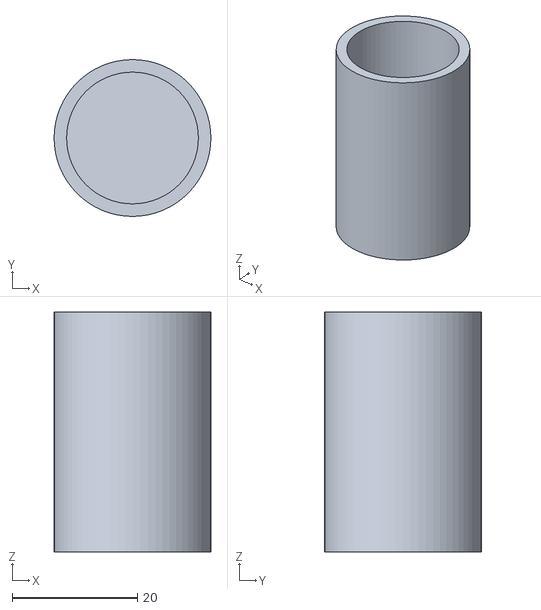
[picture p20: CAD file, 2026-05-17]
cad/jig_puck.stl
25.0 x 25.0 x 38.3
