SNI22/crucible_lite/cad/jig_cap.stl

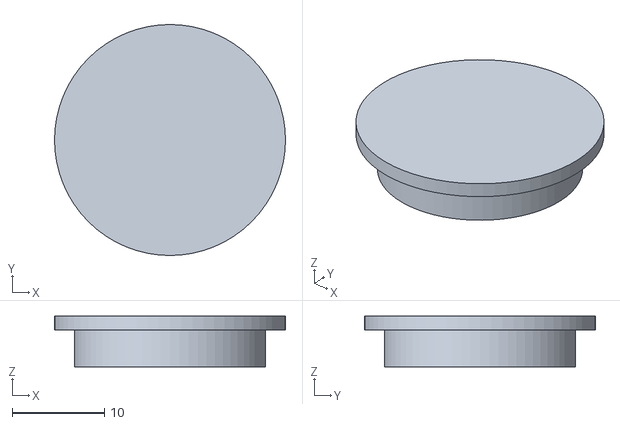
[picture p21: CAD file, 2026-05-17]
cad/jig_cap.stl
25.0 x 25.0 x 5.49
