SNI22/crucible_lite/docs/plots/sim_render/confuser_step__medium__seed42.png

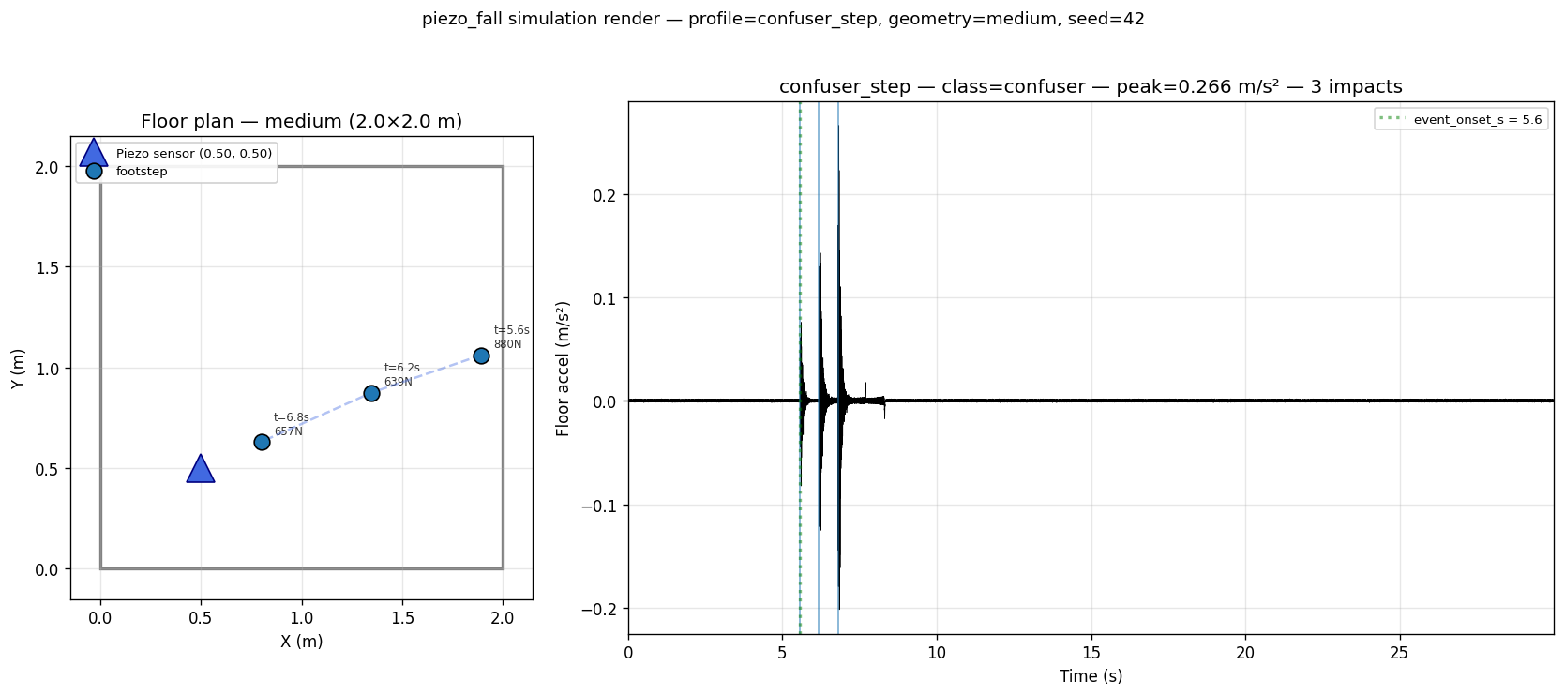
docs/plots/sim_render/confuser_step__medium__seed42.png
