SNI22/crucible_lite/(commit log)

2026-05-15 Ratify Amendment 1 and complete /spec collect for piezo_fall
    Device purpose: floor-vibration fall detection for elderly in bathroom,
    target ≥95% sensitivity / ≤1 FP/week / ≤30s latency. Three domain
    primitives ratified: P1 floor acceleration (piezo), P2 acoustic pressure
    (microphone — env classification + verbal response), P3 human room
    occupancy (WiFi sensing). Carries forward circuit, mounting, and feature
    design from ~/Documents/piezo_circuit; flags slump case and bathroom
    fall data as Stage 1 gaps.
2026-05-15 Propagate Amendment 1 primitives to 5 agent files
    agent-updater identified 5 agents whose checklists referenced "domain
    primitives" generically; inlined the project's named P1/P2/P3 primitives
    with units so each agent can enforce Article I traceability by label.
    Other 12 agents are domain-agnostic and read the live record at runtime,
    so no change. Removed "dps" (gyro/IMU unit) from plotter axis examples
    since IMU is not in baseline scope.
2026-05-15 Toolchain init: register STM32F103 PVDF PCB + Pi 5 host setup
    Sections 1-6 written: hardware (custom STM32F103 PCB with PVDF cantilever),
    pin map (11 entries from prior schematic), active toolchain (Keil MDK-ARM on
    Windows laptop, ST-Link flash, receiver.py on Pi 5, floor_sim.py for Stage 1
    simulation), no blocks (+ project cost-constraint guideline), library manifest
    (SPL pinned firmware-side, host-side TBD until /toolchain scaffold), 3 repos
    registered. Pi ADC-hat contingency path recorded as Bill-level escape valve.
    Two known Article I violations in current firmware (accur=0.015295,
    offset=1890) flagged for future Bills. Spec Gate marked CLOSED.
    /toolchain validate: 6 PASS, 1 WARNING (in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
2026-05-15 Ratify Amendments 2-4 (Stage Gate, Toolchain Alignment, Three-Strike)
    Framework amendments accepted as-written. All three are unconditional
    constraints on agent behavior:
    - A2: Stage Gate Order — no stage N+1 work until N closed by human
    - A3: Toolchain Alignment — toolchain_config.md is single source of truth
    - A4: Three-Strike Rule — stop and report after three failures
2026-05-15 Propagate A2-A4 to agents; mark uart-reader DORMANT; fix hook path
    Agent edits (9 agents, 10 files):
    - simulator-operator: new Constitutional Basis (A2/A3/A4) + A3 pre-run check
    - regression-runner: A3 row + A2 stage-gate and A3 toolchain pre-run checks
    - plotter: new Constitutional Basis (A4); scope revision deferred to scaffold
    - package-manager: A4 report contents expanded; A3 blocked-check as Rule 6
    - hw-advisor: A4 row appended (suggestion-cycle three-strike)
    - stage-compactor: new Constitutional Basis citing A2 closeout role
    - constitution-auditor: STAGE-STATUS-MISMATCH row + audit subsection for A2
    - attorney-A + attorney-B: A3 toolchain-config citation rule
    uart-reader: STATUS DORMA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
2026-05-15 Stage 0: open with adapted HIL protocol for piezo_fall architecture
    Framework default Stage 0 (4 flashable test programs) does not fit this
    project — MCU streams ADC over UART only; algorithm lives on Pi 5 host.
    Adapted protocol: 0.1 MCU alive, 0.2a ADC plausibility, 0.2b streaming
    rate >=1 kHz (resolves audit issue "sample rate is folklore"), 0.3
    receiver capture e2e, 0.4 wireless/transport (or USB-only declaration).
2026-05-15 Retarget host from Pi 5 to Linux PC (conda) for this loop
    User-directed scope change: this development loop runs on the Linux PC
    where the Crucible session lives. Pi 5 is deferred to Stage 4 (Host
    Integration). Updated all "Pi 5 host" references to "Linux PC" except
    the Pi 5 future-deployment notes. Host-side Python versions pinned from
    the conda env piezo_reader (verified live): Python 3.14.3, numpy 2.4.3,
    scipy 1.17.1, matplotlib 3.10.8, pyserial 3.5, PyQt5 5.15.11,
    pyqtgraph 0.14.0. openseespy NOT INSTALLED — flagged as Stage 1 install.
2026-05-15 Stage 0: PENDING-WITH-OPEN-FINDINGS; open Stage 1 Path A only
    Justice declaration (Article II authority): Stage 0 cannot formally close
    because the toolchain-registered firmware in PVDF压电采集资料/采集代码/
    contains no UART send code (no uart_init, no USART_SendData, no printf
    to UART). The streaming firmware that produced the prior CSVs must live
    elsewhere — most likely a modified main.c on the Windows laptop. Three
    findings recorded:
    - FW-IDENTITY-UNRESOLVED (defer to Stage 2)
    - SAMPLE-RATE-UNMEASURED (defer to Stage 2)
    - BT-BRIDGE-HYPOTHESIS-REJECTED (dead-end documented)
    Stage 1 Path A (signal-only Python simulation: floor_sim.py → signals.py
    → algorithm.py → me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
2026-05-15 Lock Stage 1 simulation profile catalog: 11 profiles, 3 classes
    Three-class taxonomy per user direction: noise (continuous ambient,
    tests baseline), confuser (discrete fall-like events, tests
    discrimination), fall (positive case, tests sensitivity).
    Profiles: noise_vent, noise_shower, noise_flush, noise_washer_local,
    noise_washer_neighbor, confuser_step, confuser_drop_{phone,heavy,glass},
    fall_fast, fall_slump. Vent humming is always-on baseline per the
    bathroom-deployment reality. Fall_slump composites slump + shower + 3 m
    range as the worst-case test of the audit's identified algorithmic
    blind spot.
    Unmodeled scenarios recorded as known deferred gaps (toilet seat slam,
    elderly-style step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
2026-05-15 Stage 1: hand-write src/signals.py — pulse-injection composer
    11-profile signal generator covering the locked catalog. Architecture
    per user direction: synthetic backgrounds always; events synthetic by
    default but substitutable with real pre-cropped CSV pulses via
    event_override parameter. Pulse format preserves receiver.py schema
    (sample_index, value, event).
    Synthetic event pulses derive from FALL_DETECTION_DESIGN.md Appendix A
    physical models (damped-oscillator base, multi-impact body fall,
    sustained slump rumble with soft final impact). Backgrounds: vent
    narrow-band hum + harmonics, shower bandpass-shaped broadband, flush
    two-phase transient, washer narrow-band ±sidebands (local) or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
2026-05-15 Stage 1: hand-write src/algorithm.py — hybrid rule+ML detector
    Pipeline per user direction (Q1-Q4):
    preprocess (rules: bandpass 2-300 Hz + 60 Hz notch)
    → detect events (rules: impulsive RMS gate + slump sustained gate)
    → extract features per event (6 from Appendix A + 2 temporal context)
    → RandomForest classifier (ML)
    → stillness gate (rules: confirmed fall = no impulsive event in next 5 s)
    Article I traceability:
    Every threshold + filter cutoff cited inline to P1 + Appendix A.
    The 8 features traced to physical models. The RF's learned weights
    are data-derived from labeled synthetic profiles (constitutional
    posture: features anchor, model is fitted parame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
2026-05-15 Refactor src/signals.py to use floor_sim.py (FEA) for impulsive events
    Per user direction: simulator must be physically grounded (spatial source
    + decay), with real-signal override capability preserved. Architecture:
    - Events are sequences of Impact(xy, time, force, duration)
    - Walking trajectory: footstep sequence at moving positions
    - Fall trajectory: clustered multi-impacts (hip/shoulder/head)
    - Drop trajectory: single or multi-impact (glass fragments)
    - Each impact's waveform = convolution of force profile with
    cached impulse response (one IR per quantized source_xy)
    - IR recovered via Wiener deconvolution of FEA response to a 5 ms
    reference half-sine (a true 1 ms ha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
2026-05-15 Add multi-geometry + composite profiles + realistic stride
    Three changes per user direction:
    1. Multi-geometry support:
    - GEOMETRIES registry with 'small' (1.5x1.5m, 12cm concrete) and
    'medium' (2x2m, 15cm concrete). bathroom_large reserved for later.
    - Per-seed geometry selection (seed % 2) for deterministic mix
    - IR cache keyed by (geometry, xy) — no collision across geometries
    - Profile recipes use fractions of slab dims (0.20-0.95 of Lx/Ly)
    so positions scale correctly across geometries
    - Piezo placement: quarter-corner per geometry (25% of slab dim from
    each wall) — corner-region but avoiding the simply-supported
    boundary's mode-shape-zero dead zo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
2026-05-15 Apply MiniSense 100 sensor model — datasheet-calibrated
    User confirmed sensor is MiniSense 100 (Measurement Specialties, part
    1005939-1). Updated cantilever transfer function from assumed
    generic values to actual datasheet specs:
    Resonance: 300 Hz → 75 Hz
    Damping: zeta=0.05 (Q=10) → zeta=0.092 (Q=5.45 from 6V/g at
    resonance / 1.1V/g baseline)
    Added 1st-order RC high-pass at LLF=6.5 Hz (from datasheet table
    for 100 MOhm bias = R48 on the STM32 PCB).
    Implications:
    - Effective bandpass: 6.5 Hz - 42 Hz at -3 dB, peak at 75 Hz
    - Shower (100-800 Hz) attenuated by 13 dB @ 100 Hz to 56 dB @ 800 Hz
    → shower-FP problem likely resolved by the sensor itself
    - F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
2026-05-15 Add real-spectrum bathroom noise floor (post-sensor)
    Per user direction: extract noise spectrum from real bathroom recordings
    and inject it as the post-sensor noise floor.
    Source: bathroom_testing/step_201505.csv quiet segments (29251 samples,
    ~30 s of bathroom-empty noise between footsteps). Spectrum
    characteristics:
    - 1/f rolloff below ~5 Hz (electronic amplifier noise)
    - Strong narrow peak at 25 Hz (environmental — likely fridge/HVAC)
    - Mains 60/120/180 Hz harmonics (modest)
    - Bathroom-specific peaks at 91/183 Hz
    - White floor at ~3e-5 V/sqrt(Hz) above 30 Hz
    Implementation:
    bg_environmental_noise() generates FFT-shaped noise matching this
    PSD parametrically: 1/sqrt(f) +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
2026-05-15 Sim-to-real verification: 100% disagreement — major Stage 1 finding
    Added scripts/sim_to_real_test.py to substitute real cropped events
    from prior repo CSVs (bathroom_testing/{step,catfood,water}_201505.csv)
    into matching synthetic profiles via the event_override mechanism.
    Result on 30 real events:
    real_step → confuser_step: 9/9 (100%) classified as FALL
    real_catfood_drop → confuser_drop: 12/12 (100%) classified as FALL
    real_water_drop → noise_flush: 9/9 (100%) classified as FALL
    This is a *complete* sim-to-real failure for confuser/noise events. The
    detector trained on synthetic data fails 100% on real events. Root cause
    likely: synthetic confusers lack mu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
2026-05-16 Archive Stage 1 session transcript
    Full Claude Code session JSONL (5.8 MB) — 2026-05-15 through 16 build
    of the Stage 1 simulator + algorithm + sim-to-real verification. Saved
    verbatim for future reference / reproducibility.
2026-05-16 Stage 1 wrap-up: classifier expansion + sim-vs-real comparison plots
    src/algorithm.py:
    - Added 5 scale-invariant features for cross-bathroom generalization:
    pre_event_rms, post_event_rms, post_pre_rms_ratio,
    low_band_energy_frac, high_band_energy_frac
    - Added SVM (RBF) training variant alongside RF
    - Fixed run() to use model.feature_cols (per-model feature subset)
    instead of hardcoded global FEATURE_COLS
    scripts/compare_classifiers.py:
    - RF-8 vs RF-13 vs SVM-13 comparison harness
    - Shared test-set refactor (validates all 3 models against same traces)
    Result (40 seeds × 13 profiles × 2 geometries):
    RF-8: sens 90.4%, FP 6.50%, ~2620/wk
    RF-13: sens 89.6%, FP 4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
2026-05-16 Resolve FW-IDENTITY + draft Bill 001 (Amendment 1 sample-rate revision)
    Active firmware located at 2026-05-16:
    ~/Documents/piezo_circuit/代码 - 调节发送频率/USER/main.c
    Key findings vs prior assumptions:
    - USART2 (PA2/PA3), not USART1 — pin map corrected
    - "%.3f\n" FireWater ASCII @ 115200 baud
    - Voltage = (ADC × 3.3 / 4069) - 1.65V — no 18× gain in this firmware
    - Streaming rate is INT_MARK-dependent: 0=~1.9kHz, 1=500Hz, 2=200Hz,
    3=100Hz, 4=50Hz — only INT_MARK=0 satisfies Amendment 1's ≥1 kHz
    - New issues: 4069 divisor typo (0.6% systematic), 1.65V hard-coded mid-rail
    - Old firmware's accur=0.015295 + 1890-ADC-offset violations do NOT
    exist in activ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
2026-05-16 Case 1: Enact Bill 001 with modification — Amendment 1 P1 → ≥1.5 kHz + CSV metadata
    Judicial Hearing ruling (2026-05-16): Position B (metadata-only) prevails on
    textual question, WITH MODIFICATION raising the rate floor from ≥1 kHz to
    ≥1.5 kHz. The raised floor mechanically enforces INT_MARK=0 (no other firmware
    setting satisfies it), achieving Position A's safety goal without embedding
    firmware-config strings into Amendment text.
    Amendment 1 P1 clause revised:
    - Rate floor: ≥ 1 kHz → ≥ 1.5 kHz
    - New mandatory CSV metadata fields: int_mark, transport,
    measured_rate_hz. CSVs missing these are inadmissible as Article I
    evidence.
    Case 1 recorded to case_law.md with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
2026-05-16 Case 2 (Bill 002): Revert A1 P1 rate floor 1.5 kHz → 1 kHz on empirical evidence
    Empirical timestamped recording at
    ~/Documents/piezo_circuit/bedroom_pilot_testing/catfood_bedroom_2.txt
    shows 47 samples in 34 ms = ~1.38 kHz effective rate over BT-SPP,
    contradicting Case 1's premise that BT could sustain 1.5-1.9 kHz.
    By-consent Justice declaration (no hearing): the evidence is
    uncontested, and a falsified premise warrants correction, not
    re-litigation of governance principles.
    Changes:
    - Amendment 1 P1: ≥1.5 kHz → ≥1 kHz (with Case 1+2 revision history)
    - case_law.md: Case 2 entry added
    - bill_002 drafted + marked ENACTED
    - toolchain_config.md SAMPLE-RATE-RESOLVED note updat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
2026-05-16 Install-time calibration design + multi-impact rebound physics for drops
    Two changes per generalization strategy review (2026-05-16):
    1. device_context.md — added Install-Time Calibration Design section
    between Operating envelope and Signal Inventory. Documents the
    three-step calibration (quiet baseline, tap test at 3 distances,
    calibration walk) as the generalization strategy of record. The
    simulator's job becomes structural-physics-only; per-bathroom
    variability is captured by calibration measurements at install.
    2. src/signals.py — added multi-impact rebound physics to
    drop_trajectory via new rebound_pattern parameter:
    'rigid' — single sharp impact (phone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
2026-05-16 Add simulation layout diagram (sensor + event zones, both geometries)
2026-05-16 Stage 1 baseline: honest sim-to-real result, hold here for real data
    Sim-to-real v2 (corrected tag mapping, distance-resolved):
    Sensitivity (catfood → fall): 6/12 = 50.0%
    False-positive rate (confusers): 8/18 = 44.4%
    Amplitude bias is dominant failure mode (close→fall regardless of class).
    This is the honest simulator-only ceiling. Further iteration won't close
    the gap without real training data.
    - src/signals.py: rename _drop_soft_pkg → _fall_softbody_surrogate (moved
    from confuser to fall class), add body_absorption_db=5.0 to fall_trajectory
    per drop-human-sensor empirical observation
    - scripts/sim_to_real_test_v2.py: corrected tag-to-class mapping
    (catfood=fal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
2026-05-17 Stage 1 finding: deployed sensor is NOT a MiniSense 100
    Verification of task #31 (BOM/marking check) — looking in the source repo
    ~/Documents/piezo_circuit/:
    1. SENSOR_MOUNTING.md: deployed sensor is a custom-assembled cantilever
    (25mm×8mm×28µm bare PVDF strip + 2-10g brass/steel proof mass at
    free end, base epoxied to floor). Stated resonance: 50-500 Hz
    depending on geometry — not the 75 Hz our simulator assumes.
    2. BOM_PVDF压电信号调理系统_2023-02-20.csv: only conditioning electronics
    (CA3140/MAX44248 front-end, 100 MΩ bias R48). No commercial sensor.
    3. Zero "MiniSense" hits in original repo. Our MiniSense 100 calibration
    was an assumption inside simulator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
2026-05-17 Correct sensor-identity finding: MiniSense 100 confirmed
    User confirmed deployed sensor IS a MiniSense 100. The earlier finding
    (04fe5b9) misread the source repo: ~/Documents/piezo_circuit/ has a
    general-purpose PVDF front-end compatible with any PVDF sensor, so its
    BOM lists only conditioning electronics and SENSOR_MOUNTING.md covers
    all three sensor configurations (bare film / custom cantilever / PZT).
    That document is reference material, not the deployment record.
    For piezo_fall the deployed sensor is MiniSense 100 — simulator's
    cantilever model (fn=75 Hz, ζ=0.092, 1.1 V/g, HP via 100 MΩ × 250 pF)
    remains datasheet-correct.
    - docs/stage_1_baseline.md: rewrite the sensor-identity se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
2026-05-17 Add sensor housing spec + real-to-sim correction data collection plan
    docs/device_context.md:
    - Populate sensor-housing section under "Pre-existing assets" with
    the deployment-specific ground_cantilever_housing CAD design:
    3-section stack (35x35mm baseplate, PCB clamp through-slot,
    30mm cylindrical cap for 200g preload), single rigid load path
    - Note why this preserves the datasheet sensor model (free-air
    cantilever, hard-on-hard contact, single-tile baseplate)
    - Cross-reference install-time tap-test verification
    docs/data_collection_protocol.md (new):
    - Real-to-sim correction plan, not just tap test. Each measurement
    type (tap IR, walk, drops, fall surrogates, noise, confusers) i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
2026-05-17 Add HTML rendition of data collection protocol with variable-control highlights
    Reading-friendly version of docs/data_collection_protocol.md. Adds
    explicit variable-control coding throughout:
    CRITICAL — sensitivity-critical; fudging breaks the comparison
    HOLD CONSTANT — must not drift within or across sessions
    MEASURE & LOG — allowed to vary but must be recorded in CSV/log
    FREE — no impact on comparability
    Highlights in red/orange cells of the per-measurement table show
    where a control slip kills the downstream fit. New "variables that
    matter most" section consolidates the can't-change-mid-study list.
    Markdown remains canonical source.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
2026-05-17 Use firmware-side name (USART2) in operator instructions
    Firmware uses USART2_Init / USART2_printf — operator instructions
    should match. Replaced 5 instances of "UART capture / UART output"
    with "USART2 capture / USART2 output" in data_collection_protocol
    {.md,.html}. CSV metadata header already used "USART2_USB" (correct
    firmware naming).
    Governance docs (device_context, bills, case_law, amendments,
    toolchain_config) retain "USB-UART" where it correctly names the
    physical-layer transport class — those aren't operator instructions
    and the term is used in its proper context.
2026-05-17 Use "impulse" (not "tap") for quantitative IR measurement; require jig
    Terminology rule applied across docs: "tap" is reserved for qualitative
    go/no-go checks (e.g. Phase 0 fingernail mount-OK verification); when
    the result is a number we fit or compare across trials/distances/
    bathrooms, the word is "impulse" — engineering-precise and forces the
    realization that the source must be calibrated.
    Consequent change: the impulse source for Phase A2-A4 is no longer
    "fingernail vs jig — operator's choice". The jig is required because
    a quantitative measurement cannot tolerate operator force variability
    (±50% on a finger tap).
    - docs/data_collection_protocol.md + .html: rename A2/A3/A4 from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
2026-05-17 Add CAD for impulse jig: parametric OpenSCAD + generated STLs
    Three printable parts for the impulse jig:
    - jig_tube.stl — vertical guide tube (ID 27, OD 33, H 260 mm) with
    integrated 70 mm dia base plate and pull-pin holes at the 230 mm
    drop-height line
    - jig_puck.stl — small cylindrical shell (OD 25, H 38 mm) that holds
    8x 15g fishing weights = 120g total; 3mm solid PLA bottom serves
    as the consistent striking face (PLA-on-porcelain ~0.3ms contact,
    spectrum out to ~1.5 kHz)
    - jig_cap.stl — friction-fit lid for the puck (tape works as
    alternative)
    impulse_jig.scad: canonical parametric source — open in OpenSCAD,
    edit weight_count / drop_height_mm / etc. at the top, r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
    [impulse_jig.scad, jig_cap.stl, jig_puck.stl, jig_tube.stl]
2026-05-17 Re-spec jig for Bambu X1C (256mm Z limit)
    Tube total print height reduced from 264mm to 250mm (fits X1C with
    6mm margin). The puck no longer needs to be fully enclosed by the
    tube when loaded — its lower 16mm is guided by the tube, the
    remaining ~22mm sticks above the top. The puck only needs guidance
    until it accelerates downward through the bore, so partial enclosure
    is functionally equivalent.
    - impulse_jig.scad: tube_extra_top_mm 30 -> 16, total print height
    250mm. Added loading funnel (5mm chamfer at tube top, +5mm dia)
    to make puck insertion easier. Added Bambu Studio print-settings
    comments per part (orientation, walls, infill, layer height).
    - build_jig_stl.py: same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
    [impulse_jig.scad, jig_tube.stl]
2026-05-17 Replace unreasonable real-world asks with safe surrogates
    The Phase B drop protocol was asking the operator to:
    - Drop a real phone × 10 (unreasonable: people care about phones)
    - Break × 10 glasses in a wet bathroom (hazard + cleanup nightmare)
    - Drop a catfood bag 30 times (more trips than needed)
    The simulator's drop classes characterize PHYSICS (rigid heavy / rigid
    medium / multi-impact / soft body), not specific objects. Replaced
    with safe surrogates that match the physics class:
    - B1 (rigid heavy): water bottle × 9 (was 15)
    - B2 (rigid medium): SURROGATE × 6 (was phone × 10)
    use power adapter brick / hardback book /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
2026-05-18 Local CI-equivalent enforcement via session-start bootstrap
    Goal: a project scaffolded by `crucible init` enforces the same 3 checks
    locally (pre-commit + pre-push) that CI runs on GitHub — Article I,
    Corpus Supremacy, Stage Gate — without making `crucible init` itself
    responsible for python-env management.
    1. crucible/cli.py: `git init -q` → `git init -q -b main`
    The CI workflow listens on push to `main` and PRs targeting `main`.
    Projects whose default branch was something else silently never
    triggered CI.
    2. templates/.githooks/pre-commit: upgraded from `article1_check.py` only
    to the full `python3 -m crucible.checks.runner --pre-commit` stack
    when crucible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
2026-05-18 Pin crucible-core to public git URL in templates/requirements.txt
    The previous line `crucible-core>=0.1.0` assumed PyPI publication. Until
    that happens, CI's `pip install -r requirements.txt` step fails with
    "No matching distribution found" before reaching the runner.
    Switch to a pip git URL on the public SNI22/crucible_lite@crucible_core
    branch. No auth needed (repo is public). Future projects scaffolded by
    `crucible init` will pull this verbatim and CI will resolve the dep on
    the first push.
    When the framework stabilizes and is published to PyPI, revert to
    `crucible-core>=0.1.0`.
2026-05-18 Stage governance to docs/.adoption/source_governance/ on re-init
    `crucible init` would silently overwrite docs/governance/amendments.md and
    case_law.md with the unratified template when re-run (or run with --force)
    in a project that already had ratified governance. This destroyed Amendment 1,
    all Judicial Hearing rulings, and any drafted bills with no warning and no
    recovery path other than digging through git history.
    That just happened to piezo_fall → piezo-circuit. Commit 76ea0a5 in the
    piezo-circuit repo re-scaffolded over the piezo_fall governance that had
    been imported in 2dc191e (one commit earlier). Amendment 1 with three
    ratified domain primitives, Case 1 + Case 2 with full attor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
